yumeno-robot/ROCKET-Spica/ロケットの写真/48187062-D314-499D-9990-CD5C8455F660-6103-0000018686FA2A86.jpg

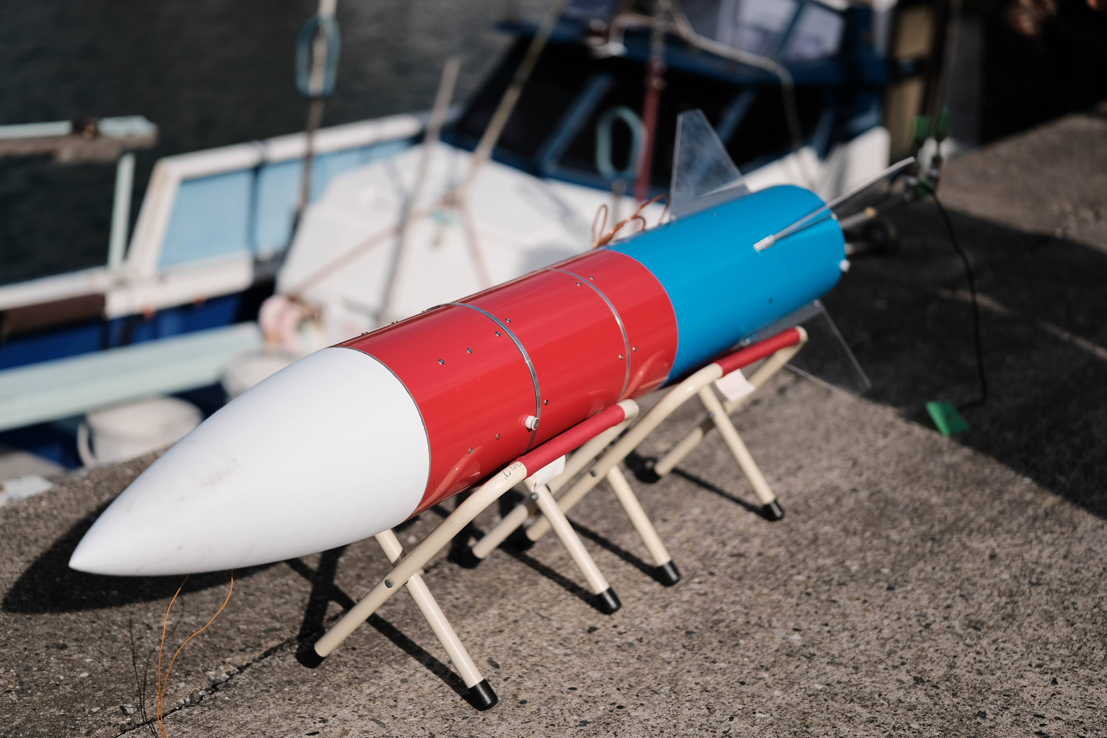
ロケットの写真/48187062-D314-499D-9990-CD5C8455F660-6103-0000018686FA2A86.jpg
