yumeno-robot/ROCKET-Spica/ロケットの写真/IMG_5005.jpg

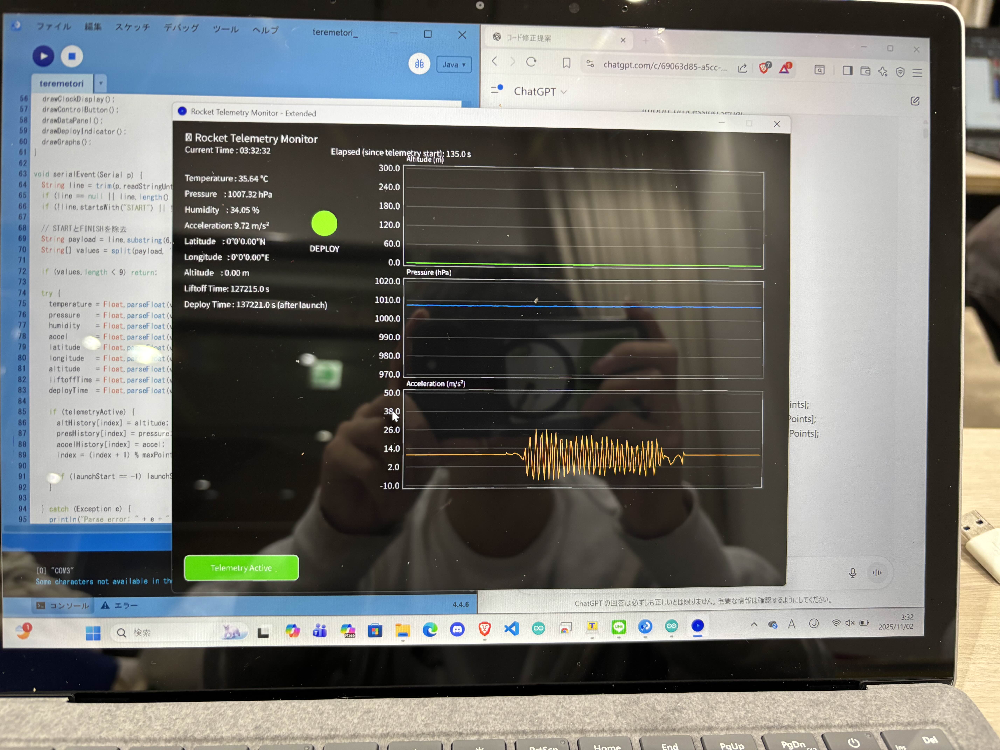
ロケットの写真/IMG_5005.jpg
