yumeno-robot/ROCKET-Spica/README.md

# 2025 年　ロケットガールズボーイ育成講座

2025 年　高校２年の時とある大学でロケット作ったのでそれのデータをまとめておきます。

★ 思い出残しのため ☆

写真データの中には私が撮ったものではないものが含まれます。
引用しないでください。
