yumeno-robot/ROCKET-Spica/A班 ロケット 使用手順書  .pdf

A 班 ロケット 使用手順書 | 第７回 御宿洋上発射実験

## 【全体像】

## ・右の写真が全体像です。

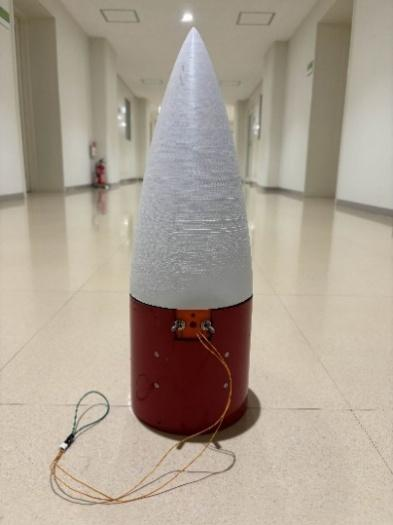
[picture p3: figure]

図１ 全体像
【部品】

### ・解放装置は主に右の写真の２

### つの部品によって構成されてい

ます。

## 左側：ノーズコーン

## 右側：機体チューブ

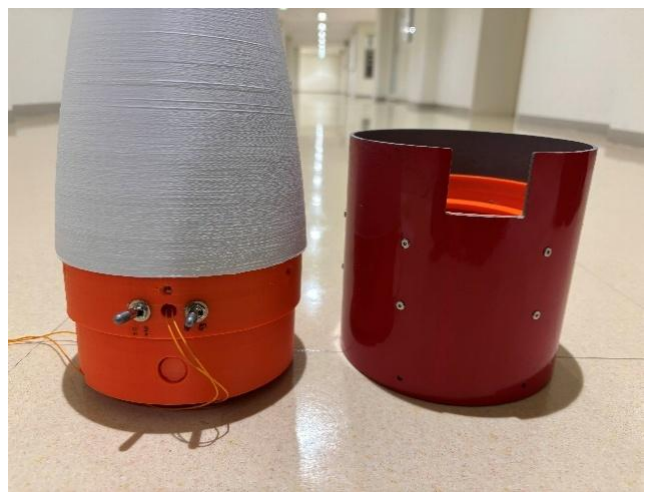
[picture p4: figure]

図２ 部品

## 【接続場所】

### ・スイッチが搭載されている部分と、

### くぼみのある機体チューブ部分を右の

### 写真のようになるように重ねてください。

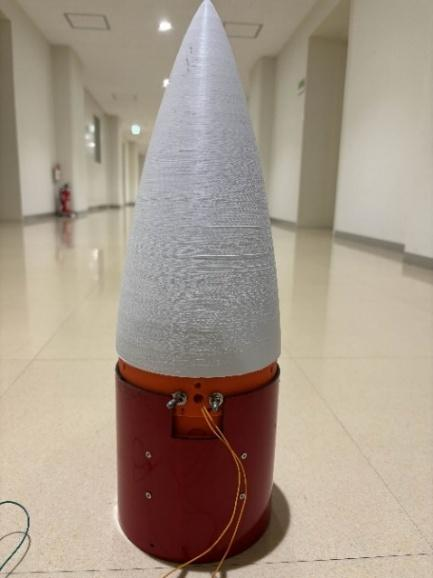
[picture p5: figure]

図３ 接続場所

## 【フライトピンの設置方法】

・２つのスイッチの間にある配線（オレンジ色の配線）の先端にジャンパーピンを取

り付け、ランチラグを囲むように接続してください。下画像の緑の配線の輪の中に、 ランチャーレールに引っかけるイメージです。

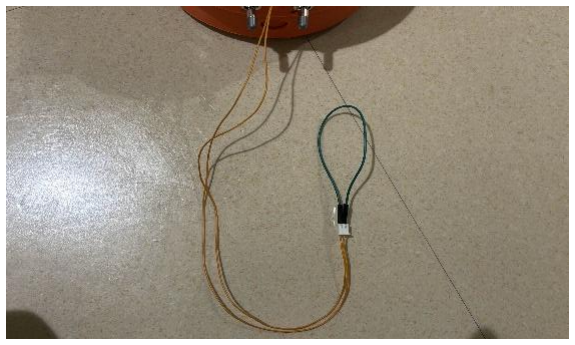
[picture p6: figure]

図４ フライトピン接続

## 【スイッチの操作方法】

・下の画像の青で囲った左側にあるスイッチは主電源スイッチです。 スイッチ左側が「ON」、
スイッチ右側が「OFF」です。
・下の画像の緑で囲った右側にあるスイッチは解放スイッチです。 スイッチ左側が「開ける」、
スイッチ右側が「閉める」です。

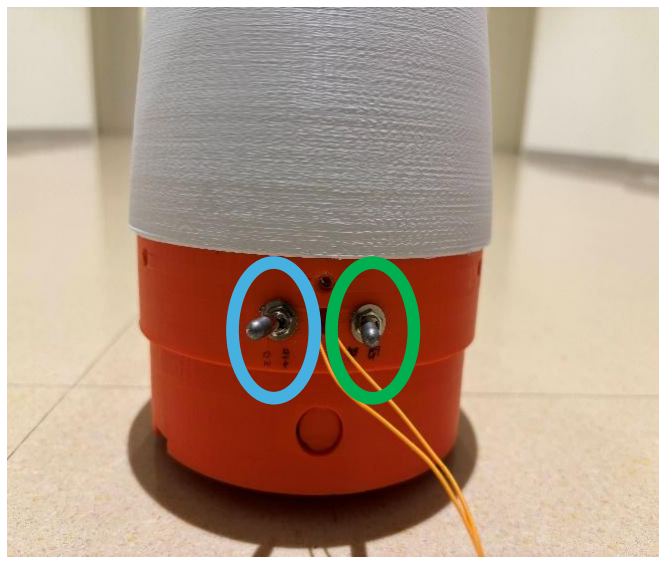
[picture p7: figure]

図５ 操作スイッチ

## 【通常手順】

① ロケットを発射台に設置してください。
② 「フライトピンの設置方法(図 4)」を参考にしてフライトピンをランチャーレール に設置してください。
③ 右側のスイッチが右側に傾いていることを確認してください。 （左側に傾いている場合、以下に示す「誤解放時」を行ってください。） ④ 左側のスイッチを操作し、電源を ON してくだい。
⑤ 電源をＯＮした後、２分ほどそのままにしてください。 （ＧＰＳが衛星と通信するまで時間をおいています。）
⑥ 以上です。

## 【誤開放時】

① 「接続場所(図３)」で示した接続場所にノーズコーンを置いてください。
② 「フライトピンの設置方法(図４)」で示したようにフライトピンを設置してくださ い。
③ 上の２つが完了したら左側のスイッチを操作し、電源を ON にしてくだい。 ④ 約５秒以上後、右側のスイッチを操作し、ピンを開けてください。
⑤ ノーズコーンを上から下に押してください。
⑥ ⑤を維持した状態で右側のスイッチを操作し、ピンを閉じてください。 ⑦ 左側のスイッチを操作し、電源を OFF にしてくだい。
⑧ 以上です。ここから通常動作を行ってください

【注意】

・「フライトピンの設置方法(図４)」で示したフライトピンの設置は電源 OFF の状態 で行ってください。電源 ON の状態でフライトピンを接続した場合、一度電源を OFF にしてからフライトピンをつなげてください。

・電源 ON 後、ロケット発射時以外にピンが抜けた場合、「通常手順」を再度行って ください。

・状態によっては右側のスイッチが右側に倒れている状態で解放機構が開いている場 合があります。その場合、前述した「誤開放時」を行ってください。
