yumeno-robot/ROCKET-Spica/ロケットの写真/0FC90A57-BD46-4F86-B61C-3EA1CAC522D2-6103-000001853AC63B2C.jpg

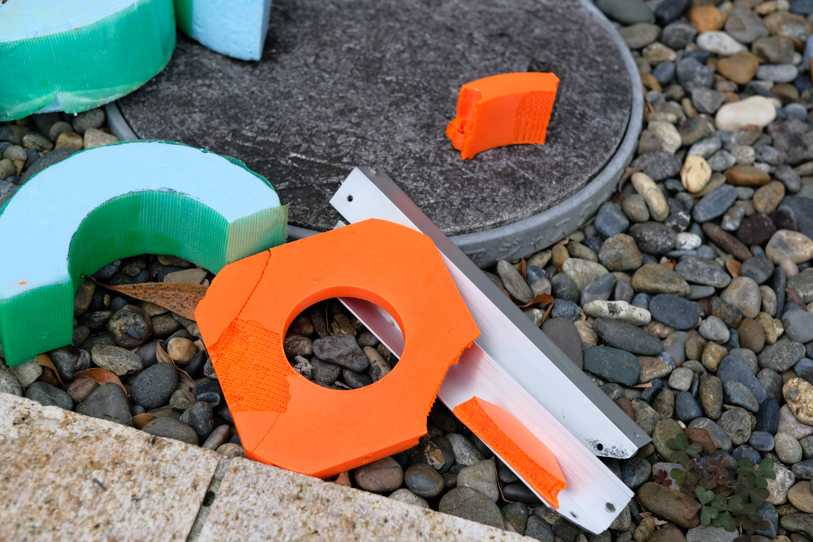
ロケットの写真/0FC90A57-BD46-4F86-B61C-3EA1CAC522D2-6103-000001853AC63B2C.jpg
