yumeno-robot/ROCKET-Spica/ロケットの写真/1CD4CB5B-3B7A-4239-A2F9-115B0FA8B15C-6103-000001851CA60BF3.jpg

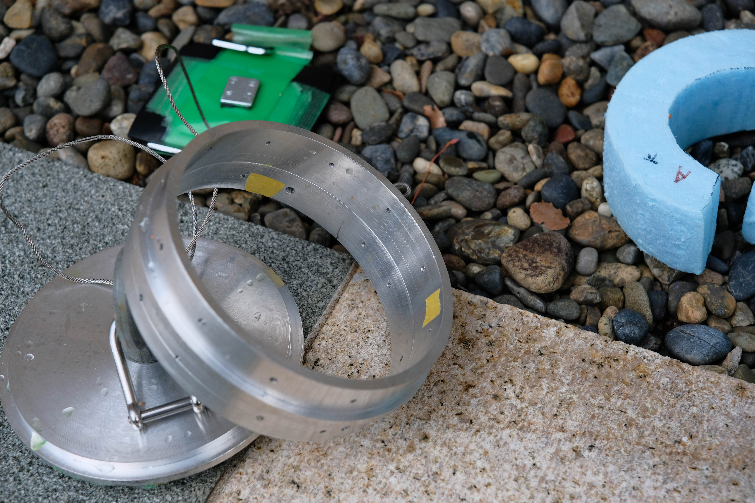
ロケットの写真/1CD4CB5B-3B7A-4239-A2F9-115B0FA8B15C-6103-000001851CA60BF3.jpg
