yumeno-robot/ROCKET-Spica/ロケットの写真/2F6D10CE-1B9F-4C32-9F9A-94F8F6FA369D-6103-00000184AF13A0E2.jpg

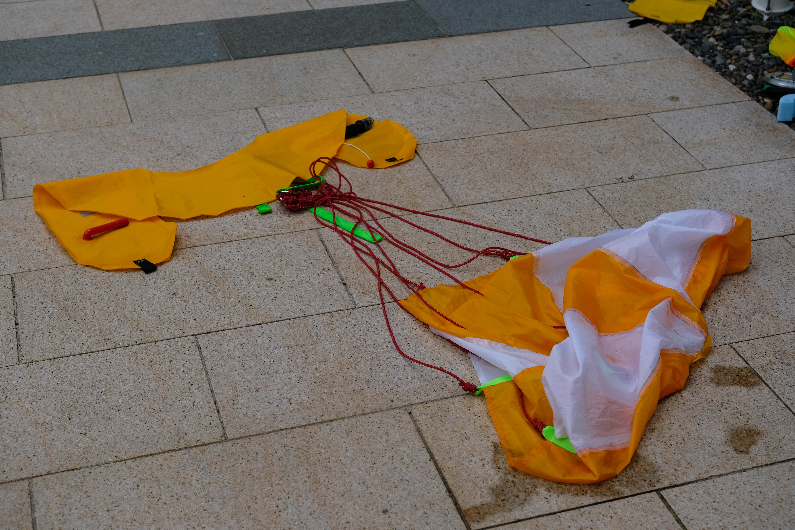
ロケットの写真/2F6D10CE-1B9F-4C32-9F9A-94F8F6FA369D-6103-00000184AF13A0E2.jpg
