yumeno-robot/ROCKET-Spica/ロケットの写真/4D69F9DE-7FC8-487E-84F1-985EA8C4742D-4056-0000011EC3DCB441.jpg

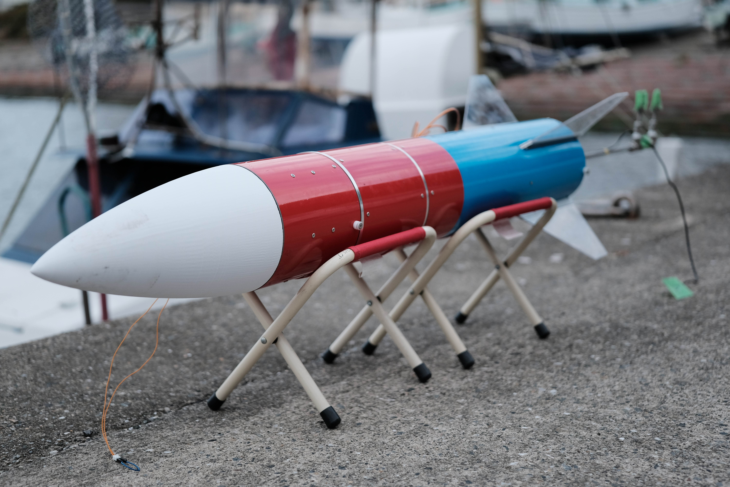
ロケットの写真/4D69F9DE-7FC8-487E-84F1-985EA8C4742D-4056-0000011EC3DCB441.jpg
