yumeno-robot/ROCKET-Spica/ロケットの写真/8B6EB3DB-4AFF-46E7-9A49-E1A825BA8A68-6103-000001863AD62E09.jpg

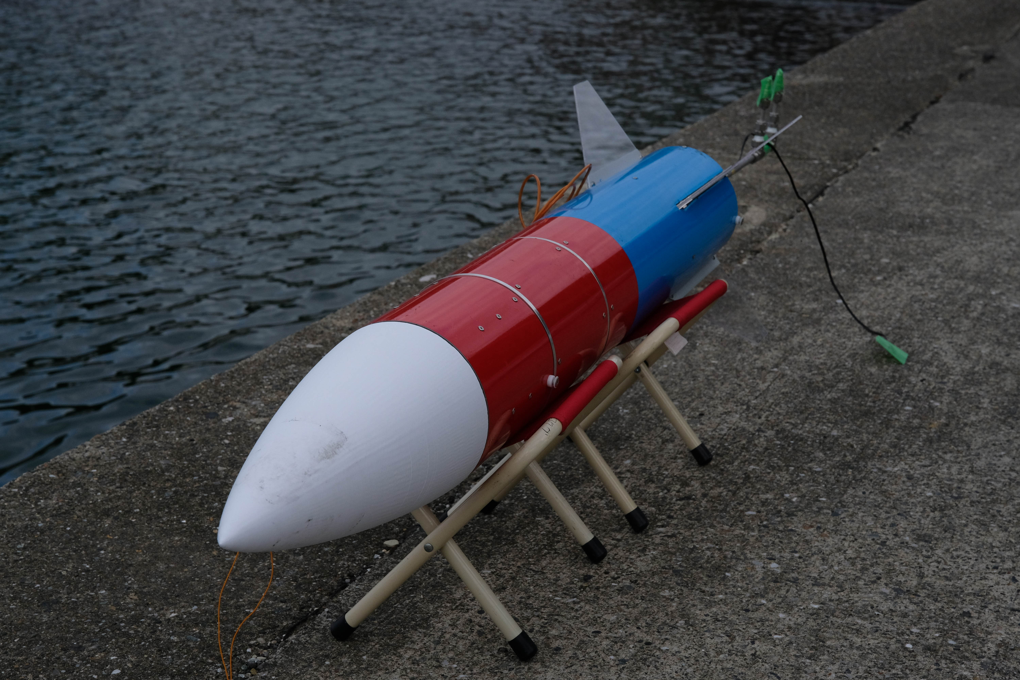
ロケットの写真/8B6EB3DB-4AFF-46E7-9A49-E1A825BA8A68-6103-000001863AD62E09.jpg
