yumeno-robot/ROCKET-Spica/ロケットの写真/675B1E63-8A9D-4DF6-90D7-148300A42DEA-44823-0000099A16C7EF28.jpg

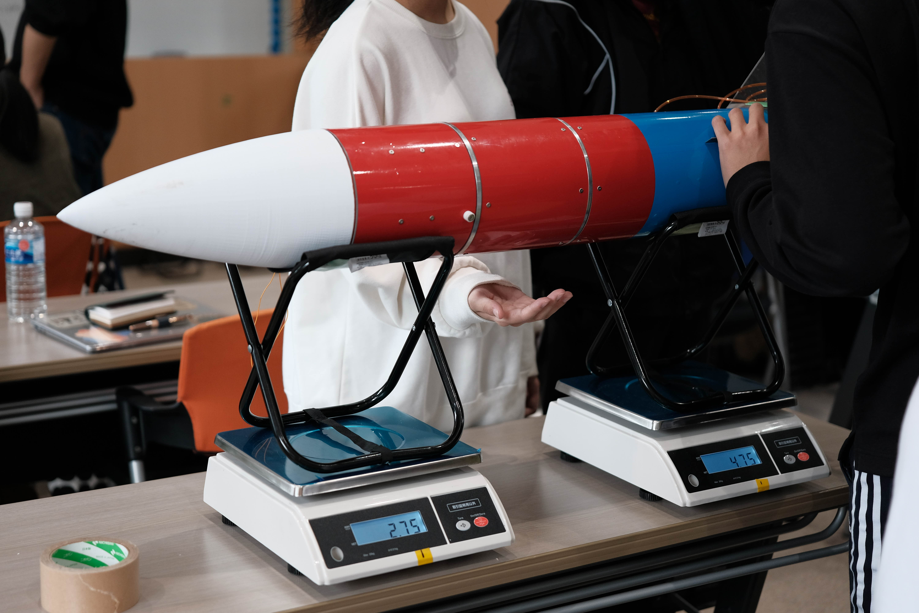
ロケットの写真/675B1E63-8A9D-4DF6-90D7-148300A42DEA-44823-0000099A16C7EF28.jpg
