yumeno-robot/ROCKET-Spica/ロケットの写真/894C506B-190F-47E7-8913-344BC54AA54C-6103-000001850DC50F10.jpg

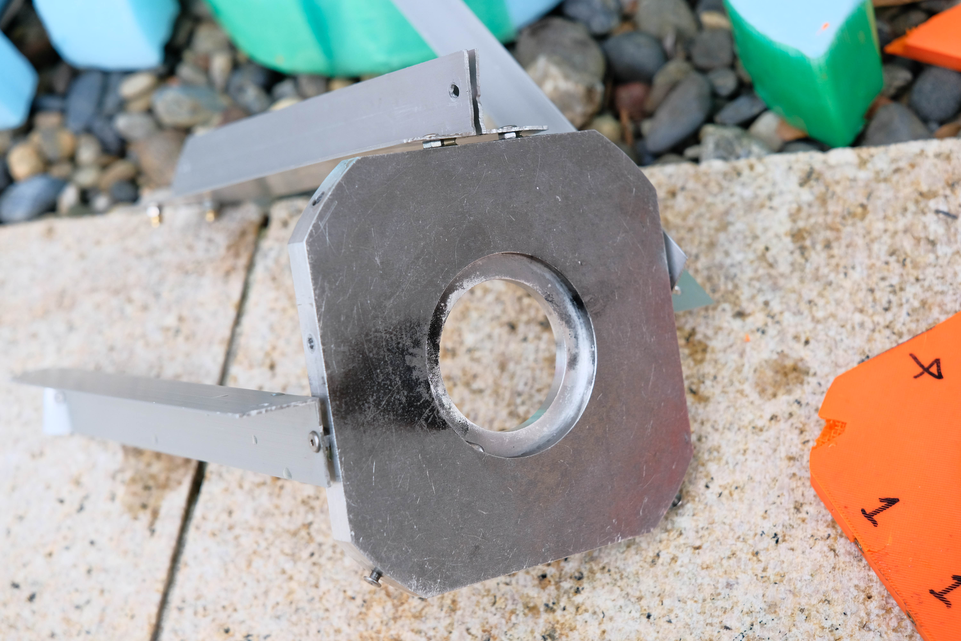
ロケットの写真/894C506B-190F-47E7-8913-344BC54AA54C-6103-000001850DC50F10.jpg
