yumeno-robot/ROCKET-Spica/ロケットの写真/4950B2CF-F425-4C80-BBA5-A1028AC1AF88-6103-00000184D413493E.jpg

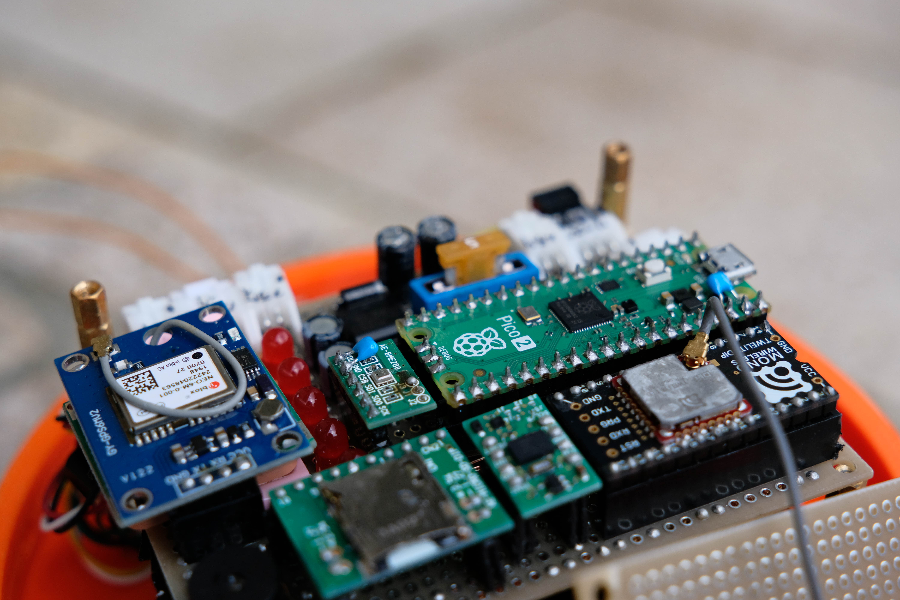
ロケットの写真/4950B2CF-F425-4C80-BBA5-A1028AC1AF88-6103-00000184D413493E.jpg
