yumeno-robot/ROCKET-Spica/ロケットの写真/210455AF-9EFC-4293-8BE5-35B574340314-6103-000001852D3EDECA.jpg

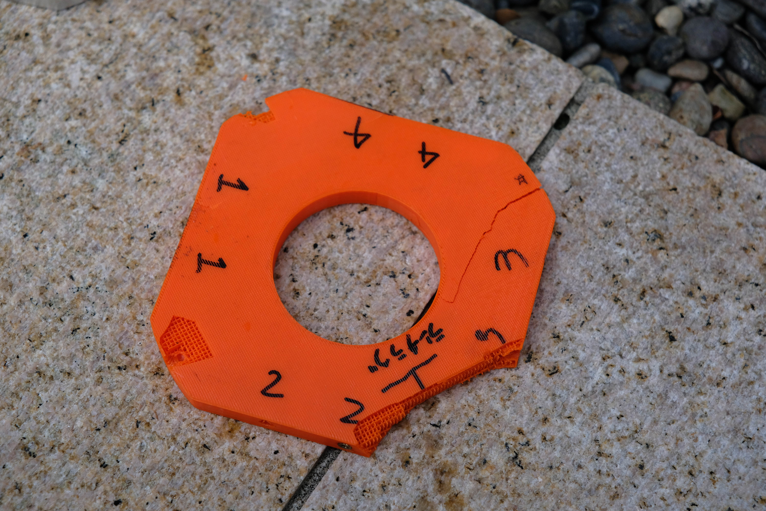
ロケットの写真/210455AF-9EFC-4293-8BE5-35B574340314-6103-000001852D3EDECA.jpg
