yumeno-robot/ROCKET-Spica/ロケットの写真/877230B7-5BA3-433E-8952-C34C328BABE0-44823-00000999D73E7EAC.jpg

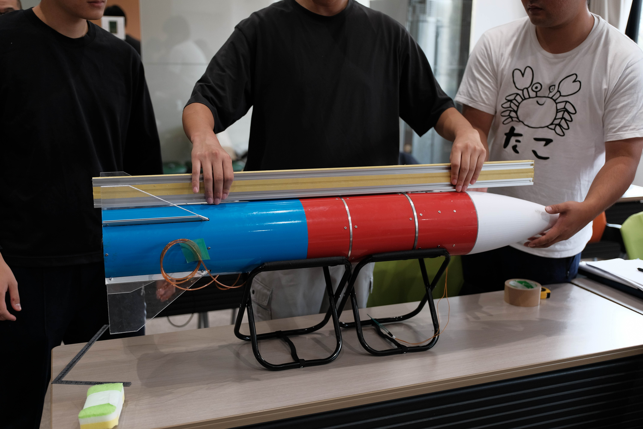
ロケットの写真/877230B7-5BA3-433E-8952-C34C328BABE0-44823-00000999D73E7EAC.jpg
