yumeno-robot/ROCKET-Spica/ロケットの写真/928958B4-A0EA-4850-AB8D-C0FD10C378C6-44823-000009990B5FE514.jpg

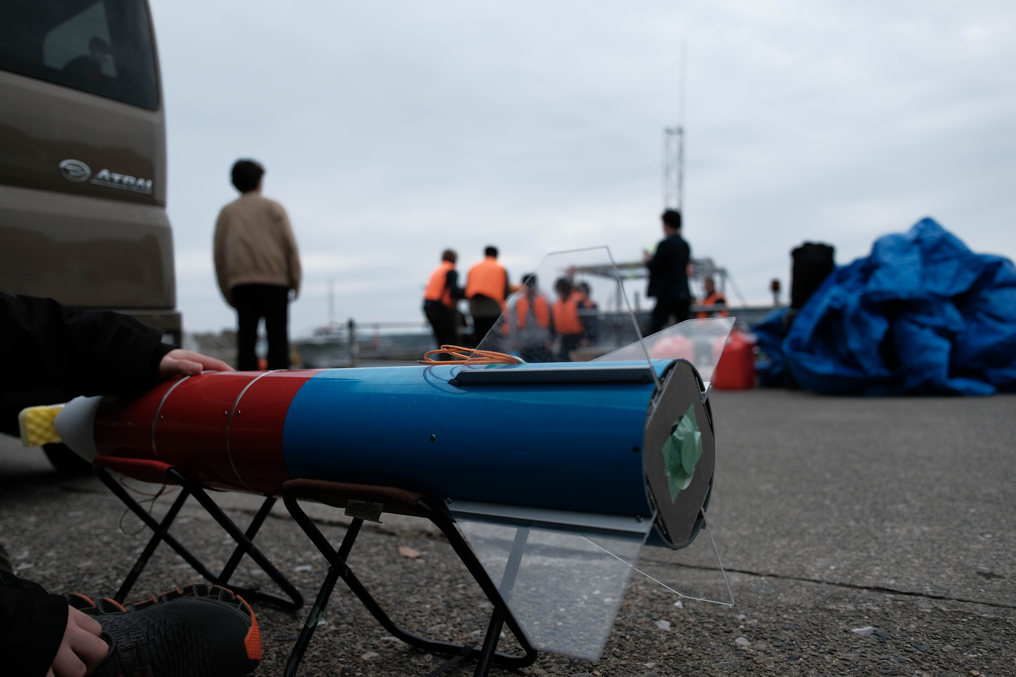
ロケットの写真/928958B4-A0EA-4850-AB8D-C0FD10C378C6-44823-000009990B5FE514.jpg
