yumeno-robot/ROCKET-Spica/ロケットの写真/A9FA2B79-7A4F-4A39-996E-ED2CC38B4577-6103-00000186A8F1BF98.jpg

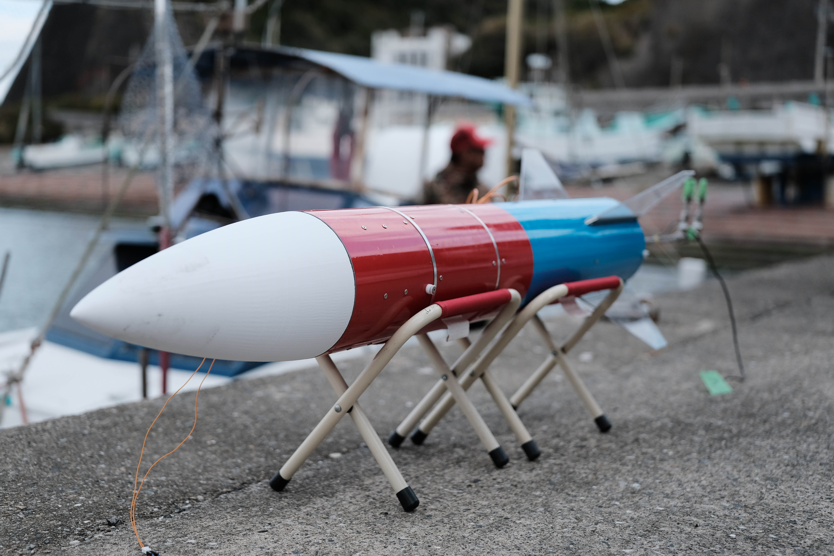
ロケットの写真/A9FA2B79-7A4F-4A39-996E-ED2CC38B4577-6103-00000186A8F1BF98.jpg
