yumeno-robot/ROCKET-Spica/ロケットの写真/A365B580-1068-411D-A24B-DBDF7330468E-6103-00000184F07EAC1B.jpg

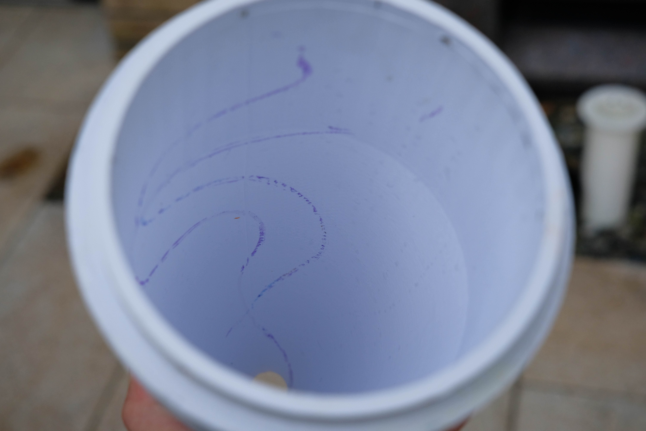
ロケットの写真/A365B580-1068-411D-A24B-DBDF7330468E-6103-00000184F07EAC1B.jpg
