yumeno-robot/ROCKET-Spica/ロケットの写真/BC89DCE3-93C0-48F0-8FF4-2F83AFA3876C-6103-00000184E5706E08.jpg

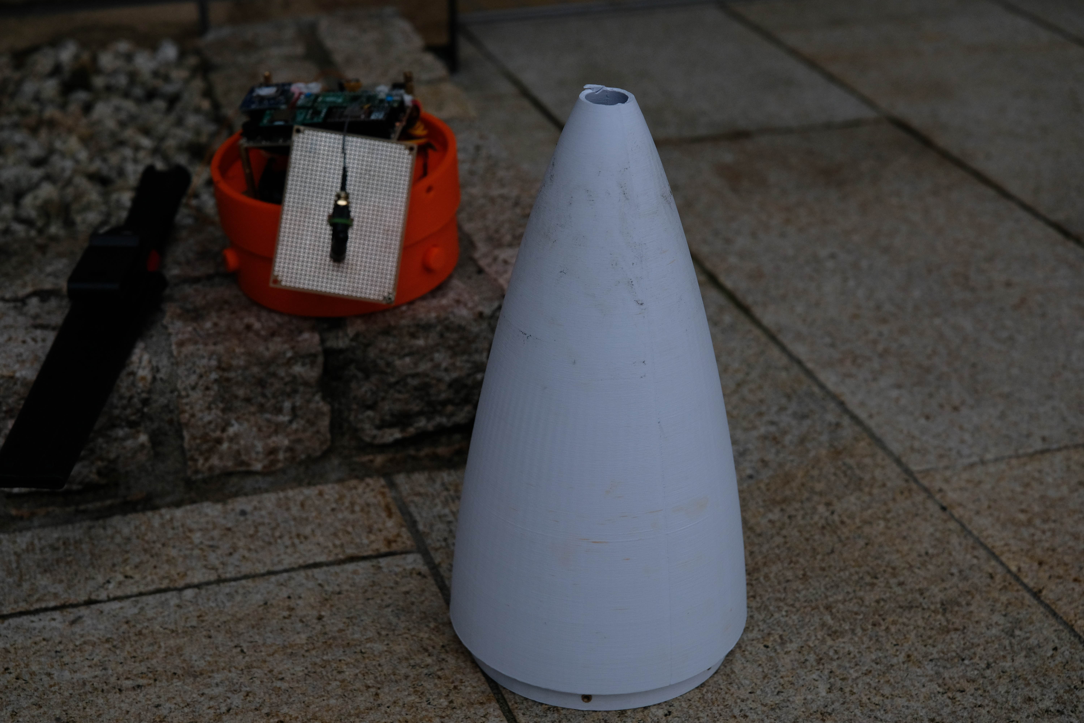
ロケットの写真/BC89DCE3-93C0-48F0-8FF4-2F83AFA3876C-6103-00000184E5706E08.jpg
