yumeno-robot/ROCKET-Spica/ロケットの写真/BD18CD77-5427-4790-9A3F-752F933EEAA5-4056-0000011ED44F400C.jpg

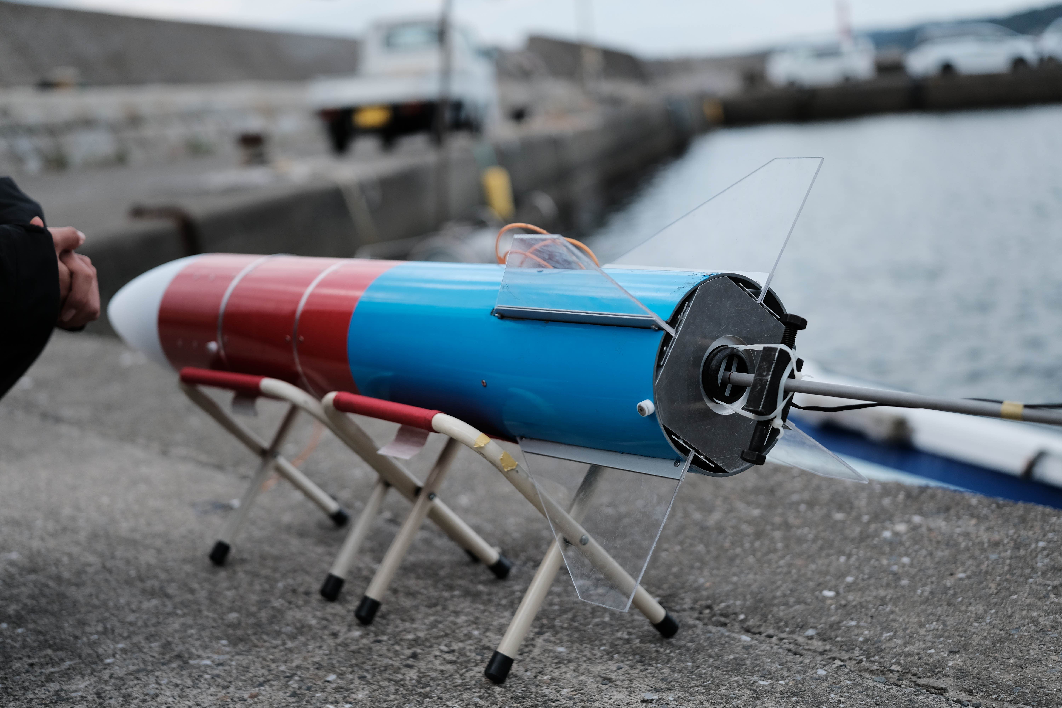
ロケットの写真/BD18CD77-5427-4790-9A3F-752F933EEAA5-4056-0000011ED44F400C.jpg
