yumeno-robot/ROCKET-Spica/ロケットの写真/C8CE9DC4-7D7F-4F7A-AB00-0D97CFE91414-6103-000001850279BE9D.jpg

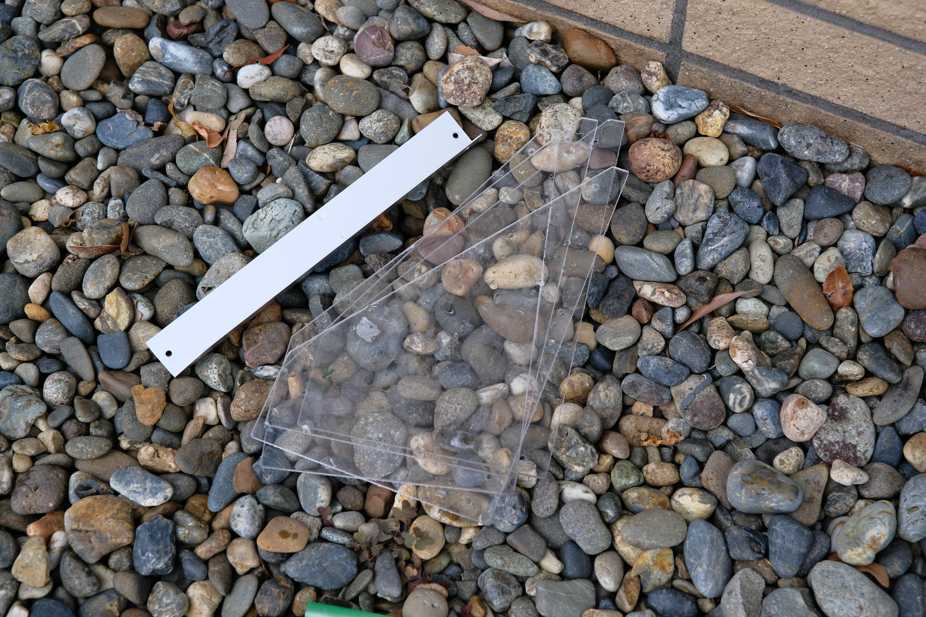
ロケットの写真/C8CE9DC4-7D7F-4F7A-AB00-0D97CFE91414-6103-000001850279BE9D.jpg
