yumeno-robot/ROCKET-Spica/ロケットの写真/CDED8A6D-13CD-4E98-A0E0-FBBDD8B04306-6103-0000018545E437C1.jpg

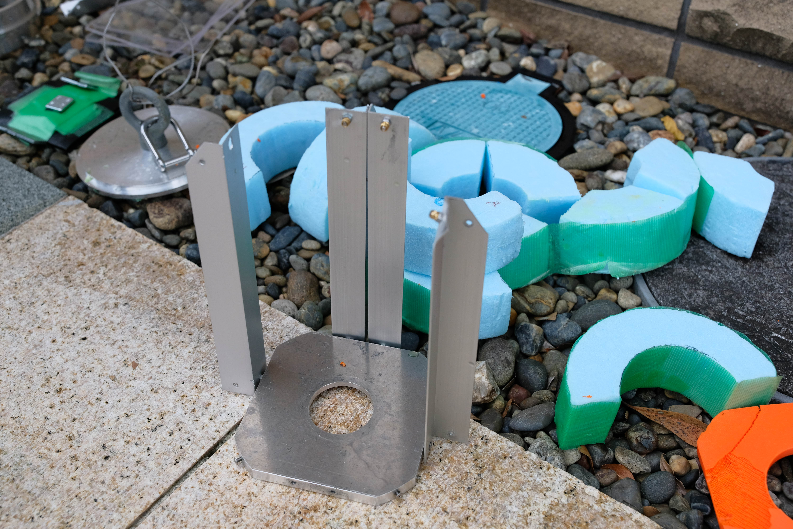
ロケットの写真/CDED8A6D-13CD-4E98-A0E0-FBBDD8B04306-6103-0000018545E437C1.jpg
