yumeno-robot/ROCKET-Spica/ロケットの写真/D8361926-20F7-44C3-A4CB-8BE9D1C3B104-6103-00000184C01F9074.jpg

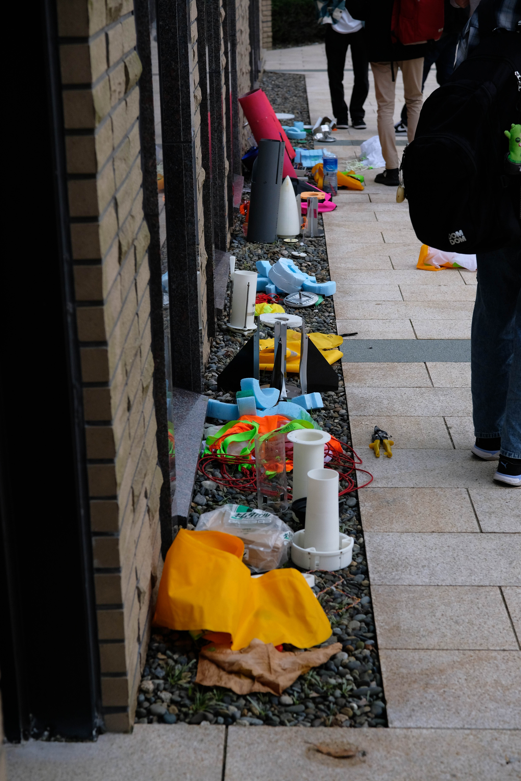
ロケットの写真/D8361926-20F7-44C3-A4CB-8BE9D1C3B104-6103-00000184C01F9074.jpg
