yumeno-robot/ROCKET-Spica/ロケットの写真/DSC1547_Original.jpg

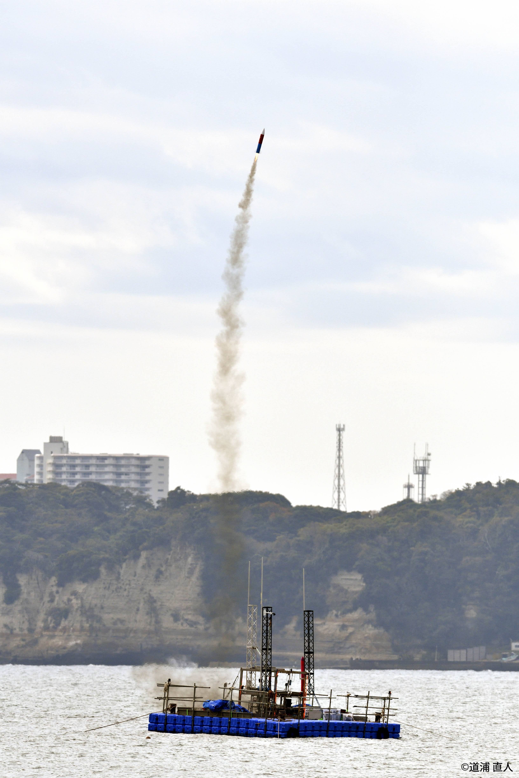
ロケットの写真/DSC1547_Original.jpg
