yumeno-robot/ROCKET-Spica/ロケットの写真/DSC2054_Original.jpg

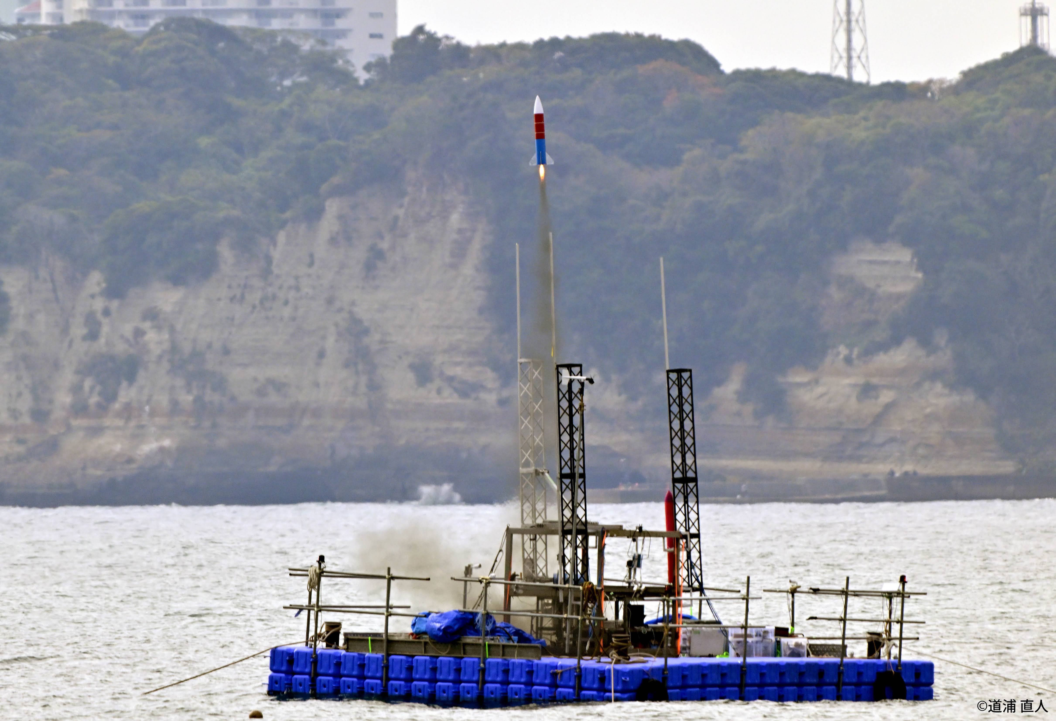
ロケットの写真/DSC2054_Original.jpg
