yumeno-robot/ROCKET-Spica/ロケットの写真/DSC2071_Original.jpg

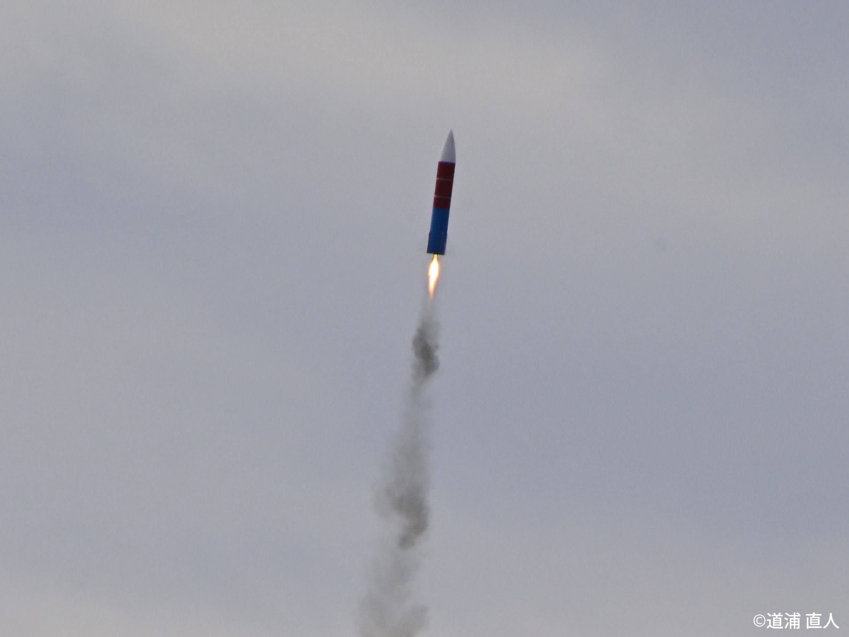
ロケットの写真/DSC2071_Original.jpg
