yumeno-robot/ROCKET-Spica/ロケットの写真/DSC2210_Original.jpg

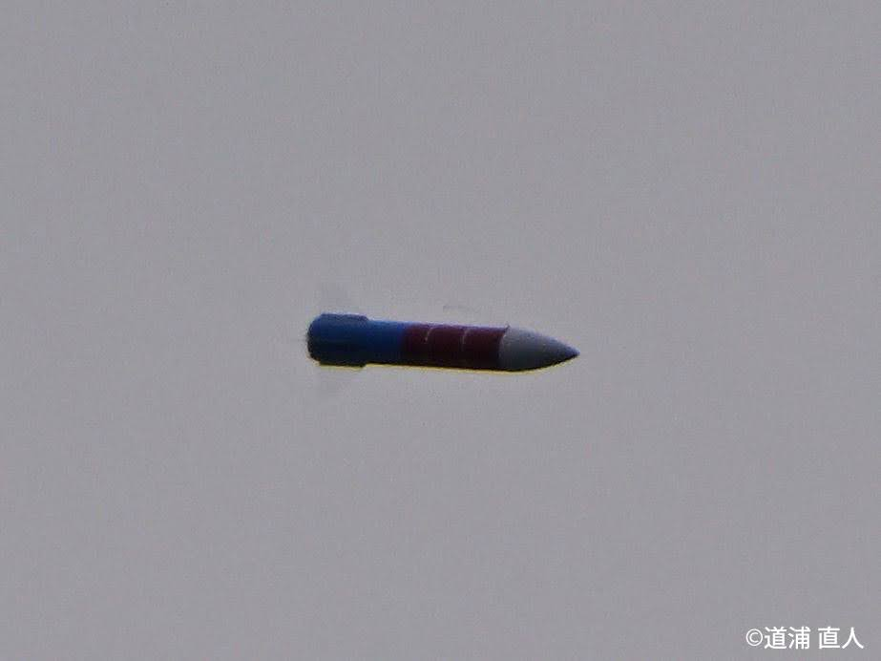
ロケットの写真/DSC2210_Original.jpg
