yumeno-robot/ROCKET-Spica/ロケットの写真/DSC2316_Original.jpg

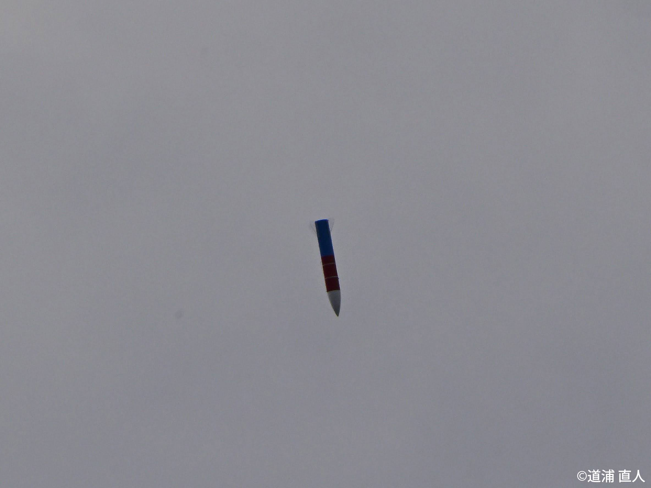
ロケットの写真/DSC2316_Original.jpg
