yumeno-robot/ROCKET-Spica/ロケットの写真/DSC2340_01_Original.jpg

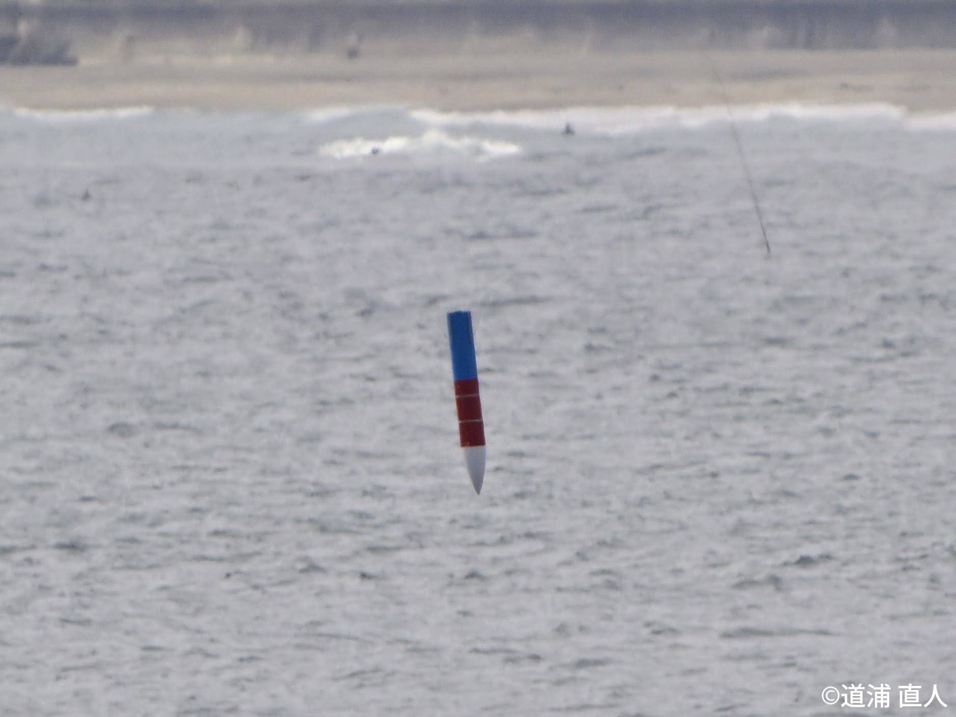
ロケットの写真/DSC2340_01_Original.jpg
