yumeno-robot/ROCKET-Spica/ロケットの写真/E9909897-1351-40BC-B9DE-F3F1F30117BF-6103-00000186566A3C08.jpg

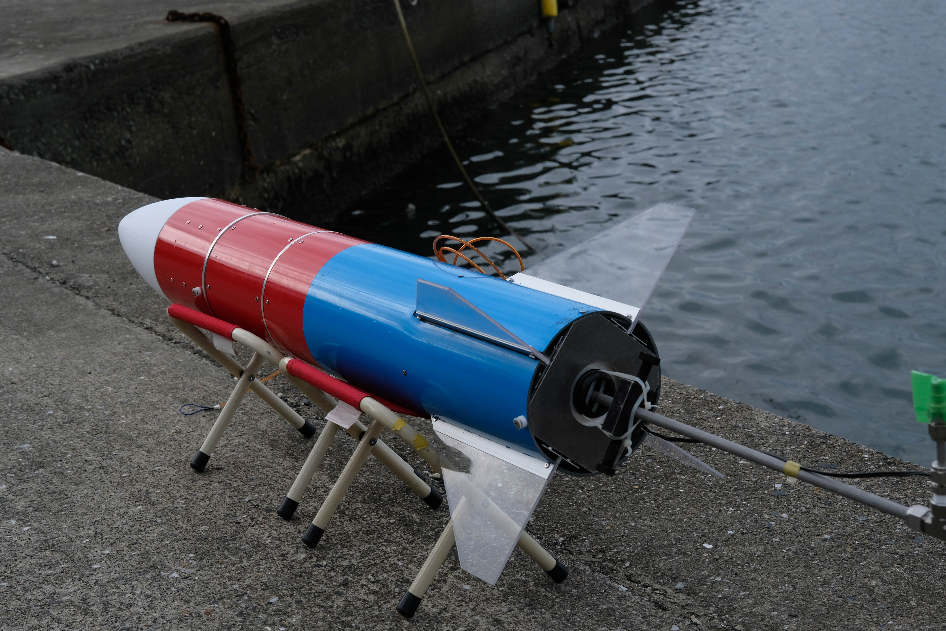
ロケットの写真/E9909897-1351-40BC-B9DE-F3F1F30117BF-6103-00000186566A3C08.jpg
