yumeno-robot/ROCKET-Spica/ロケットの写真/ED5EF804-89DA-4306-BC5D-3A83CC1A1FF2-6103-000001858AFEE430.jpg

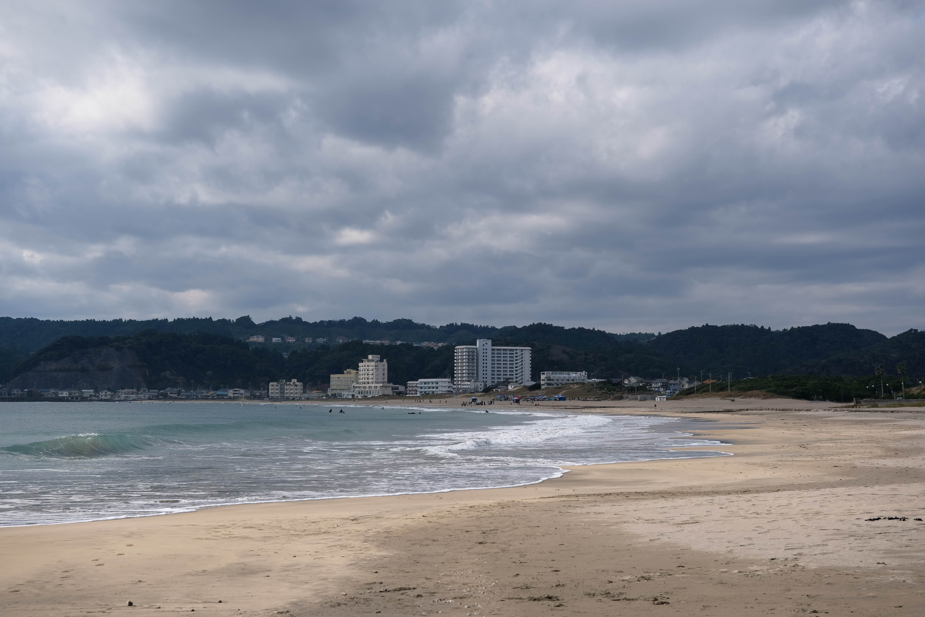
ロケットの写真/ED5EF804-89DA-4306-BC5D-3A83CC1A1FF2-6103-000001858AFEE430.jpg
