yumeno-robot/ROCKET-Spica/ロケットの写真/EEB0203D-555C-47D5-9C63-FC9DA25AA20E-6103-00000186E50B3417.jpg

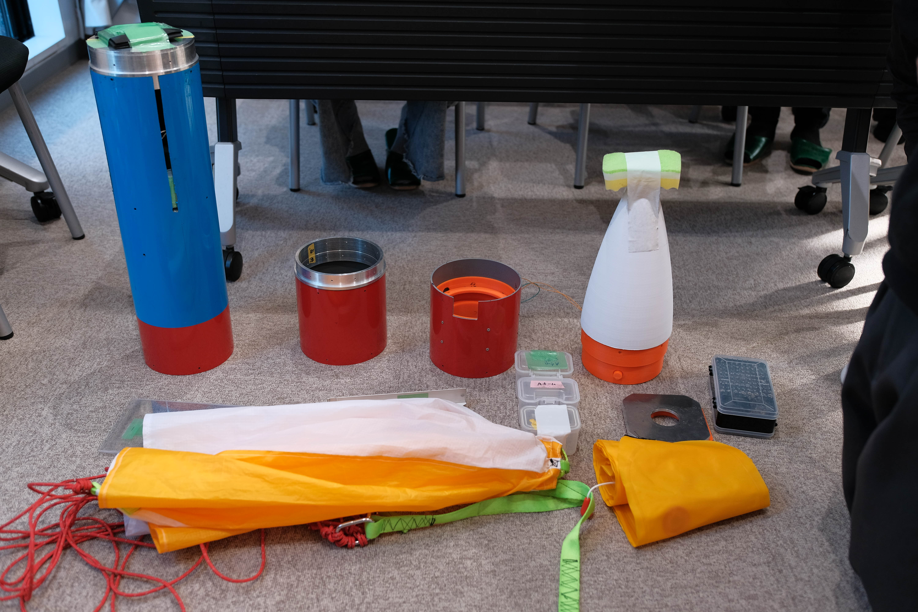
ロケットの写真/EEB0203D-555C-47D5-9C63-FC9DA25AA20E-6103-00000186E50B3417.jpg
