yumeno-robot/ROCKET-Spica/ロケットの写真/IMG_4200_Original.jpg

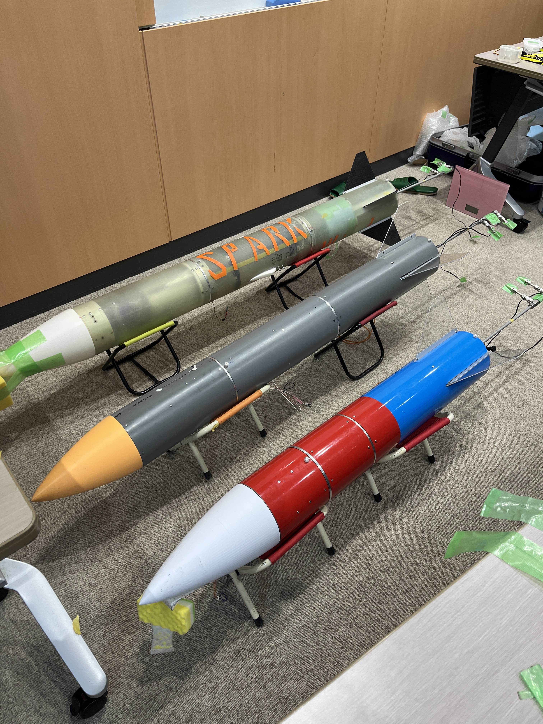
ロケットの写真/IMG_4200_Original.jpg
