yumeno-robot/ROCKET-Spica/ロケットの写真/IMG_4871.jpg

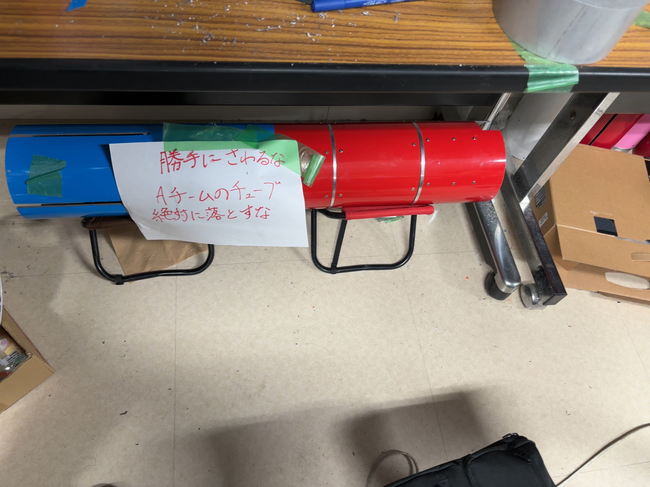
ロケットの写真/IMG_4871.jpg
