yumeno-robot/ROCKET-Spica/ロケットの写真/IMG_4982.jpg

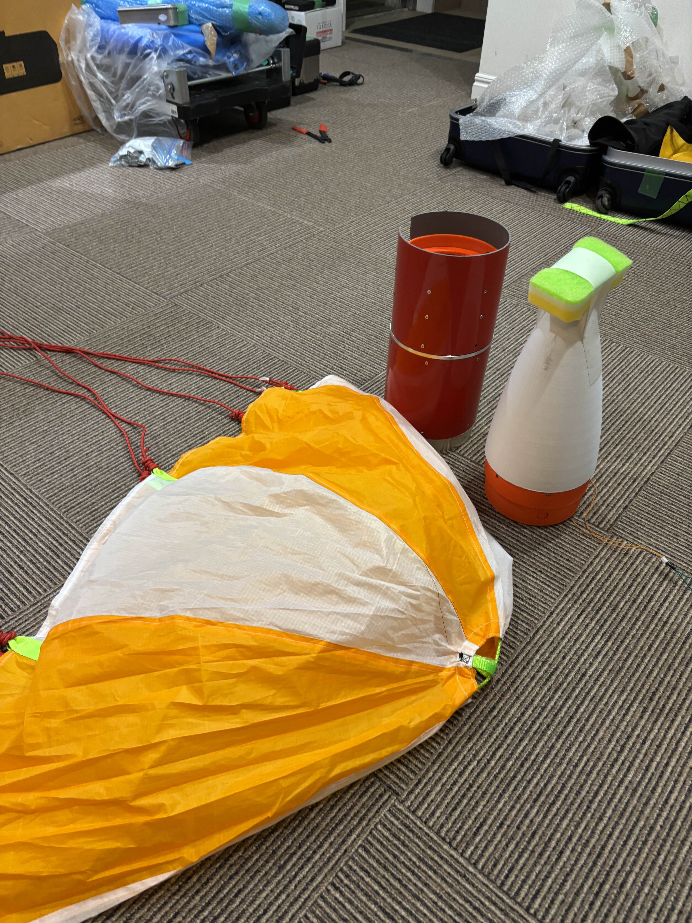
ロケットの写真/IMG_4982.jpg
