yumeno-robot/ROCKET-Spica/ロケットの写真/IMG_4983.jpg

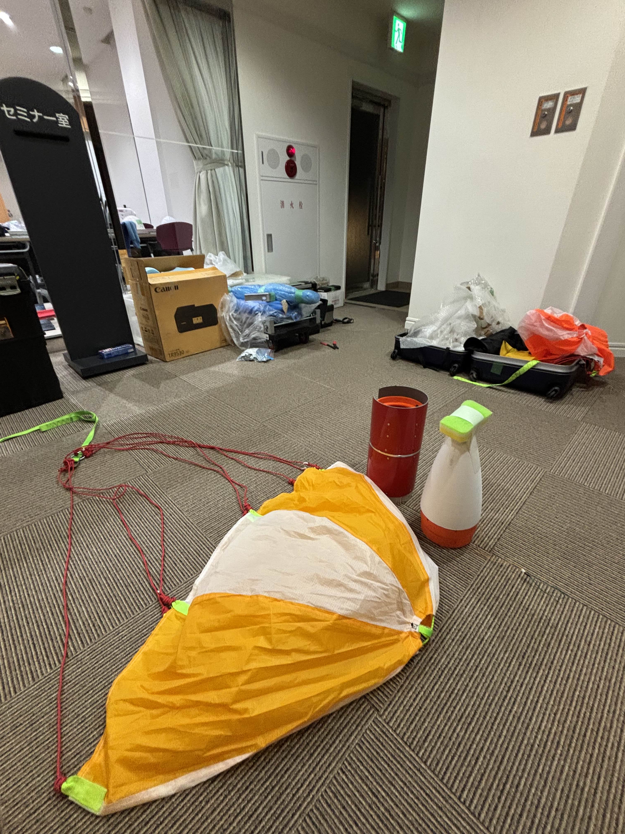
ロケットの写真/IMG_4983.jpg
