yumeno-robot/ROCKET-Spica/ロケットの写真/IMG_4984.jpg

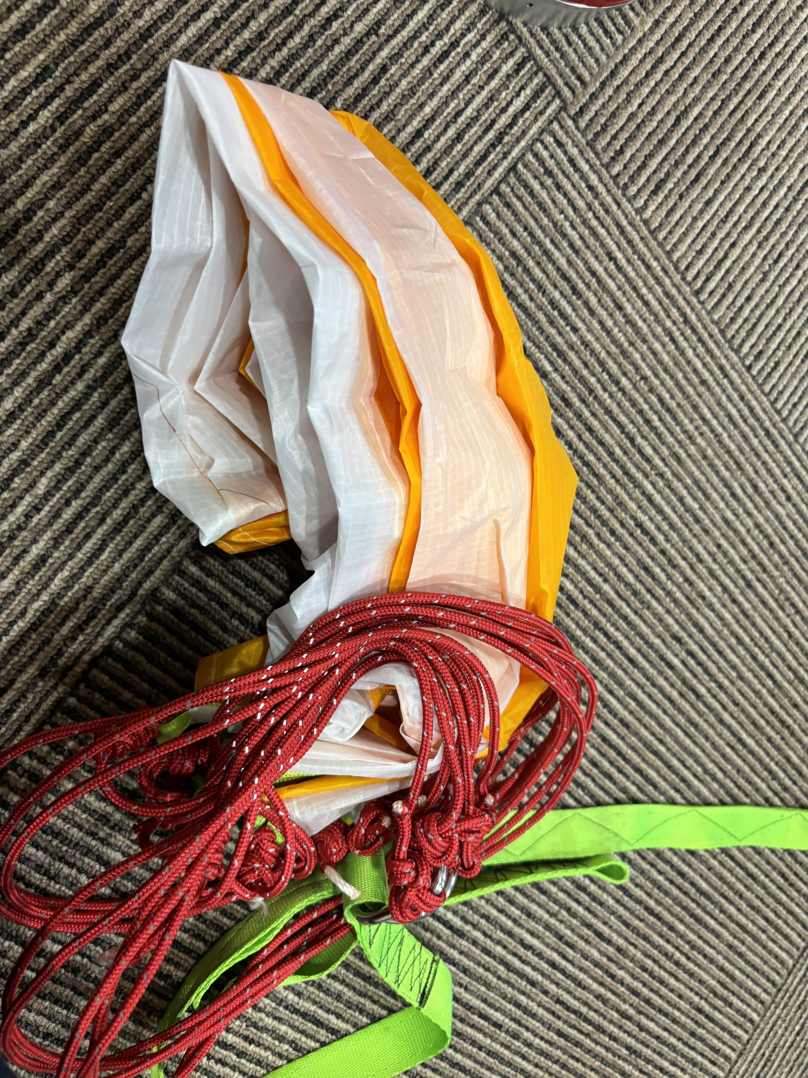
ロケットの写真/IMG_4984.jpg
