yumeno-robot/ROCKET-Spica/ロケットの写真/IMG_5441.jpg

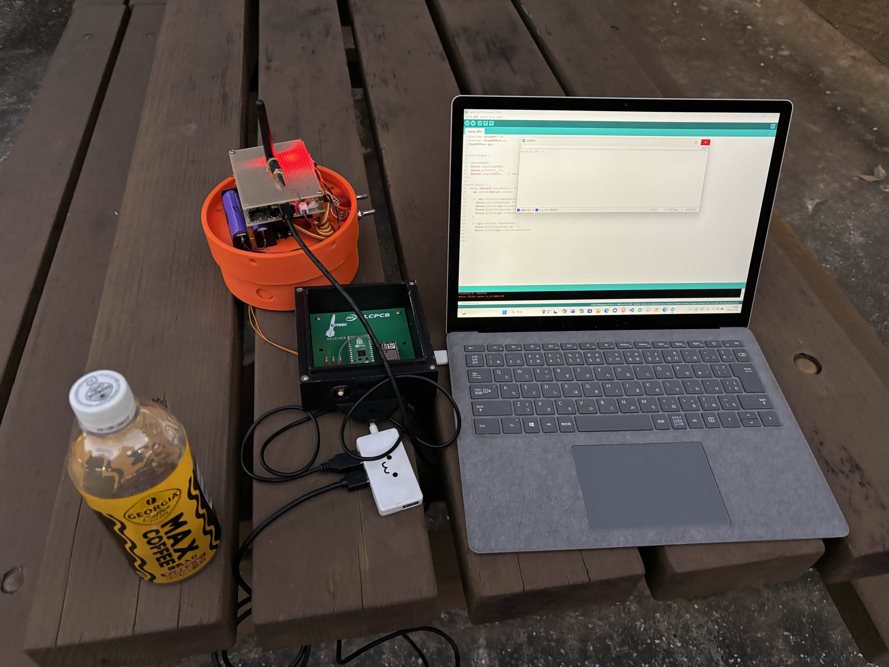
ロケットの写真/IMG_5441.jpg
