yumeno-robot/ROCKET-Spica/ロケットの写真/IMG_5715.jpg

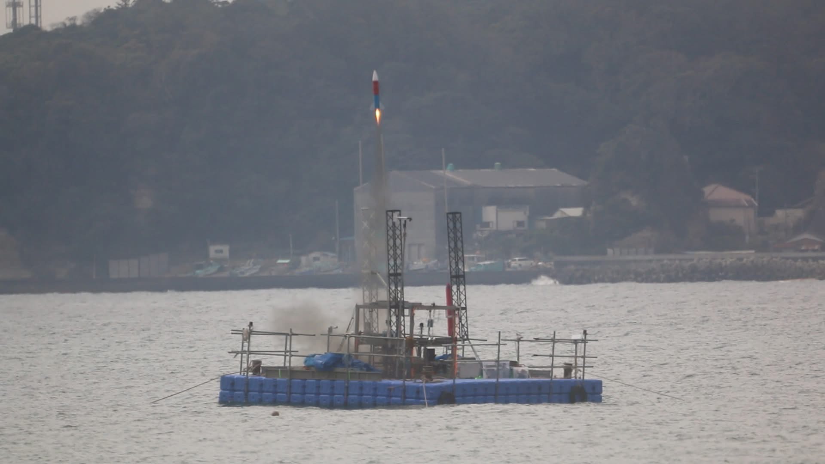
ロケットの写真/IMG_5715.jpg
