yumeno-robot/ROCKET-Spica/ロケットの写真/IMG_5728.jpg

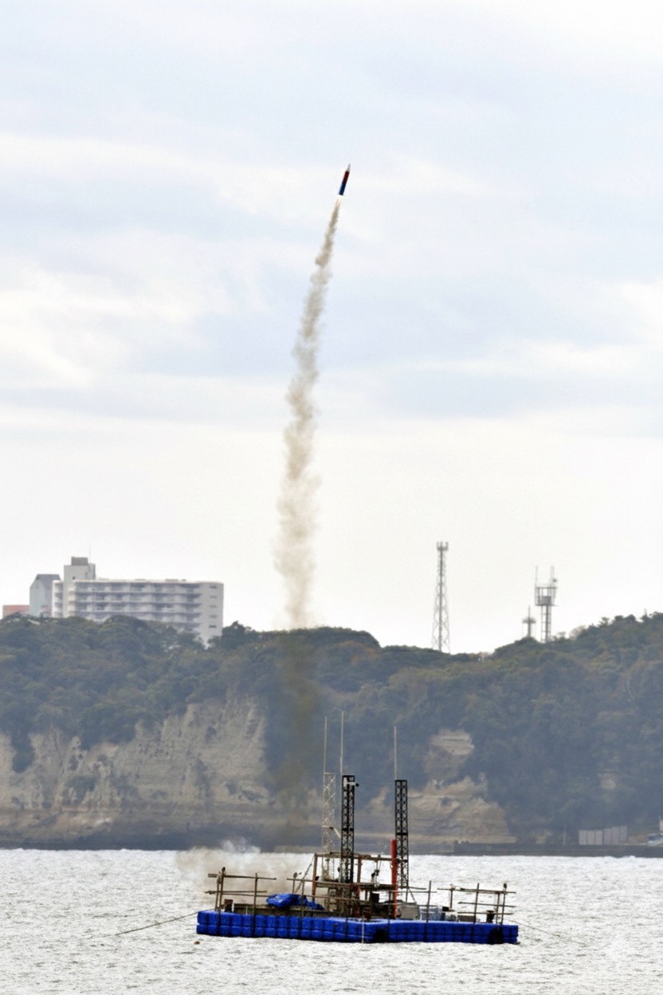
ロケットの写真/IMG_5728.jpg
