yumeno-robot/ROCKET-Spica/解析データ/GPSが動いてる証拠.png

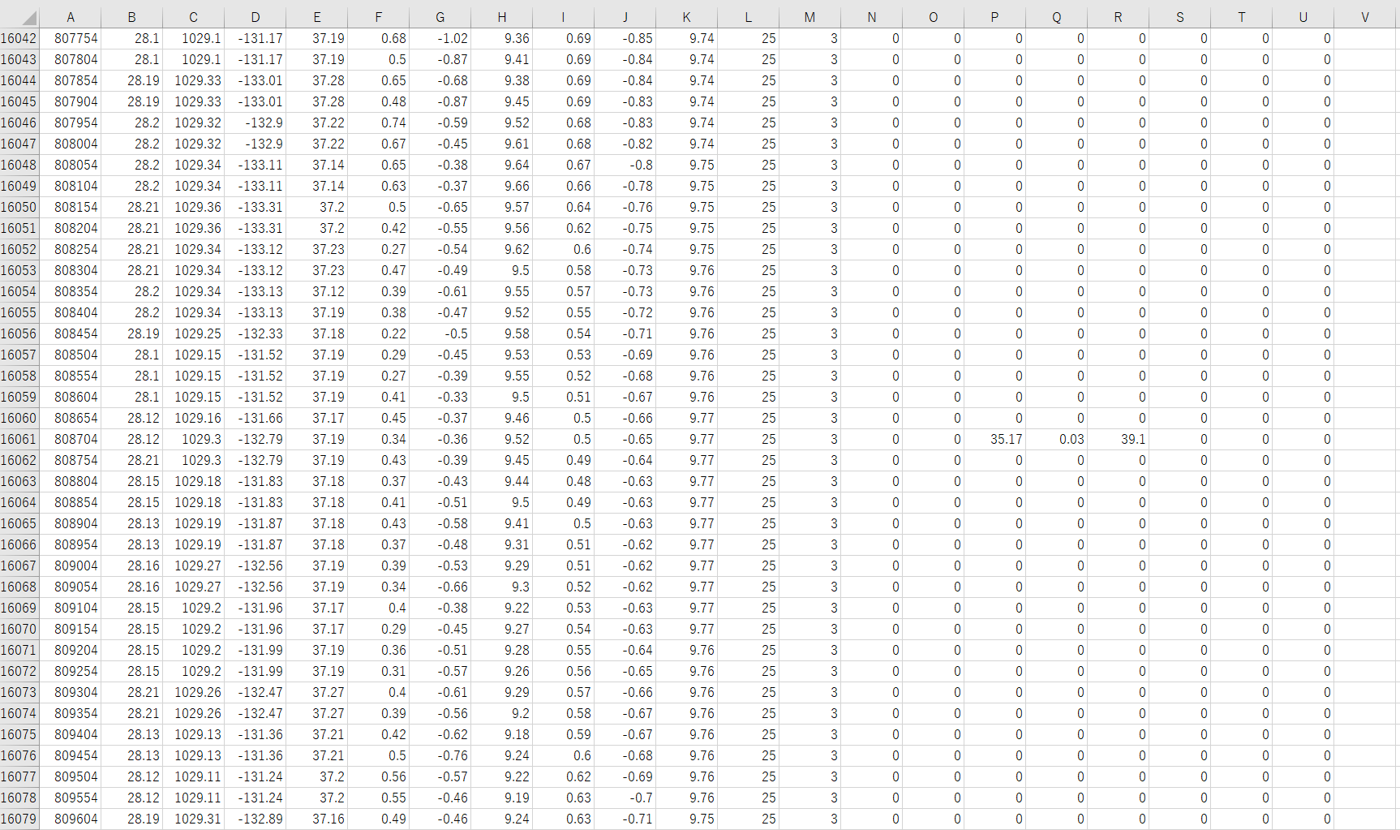
解析データ/GPSが動いてる証拠.png
