yumeno-robot/ROCKET-Spica/解析データ/SDカードに書きこんだデータ.png

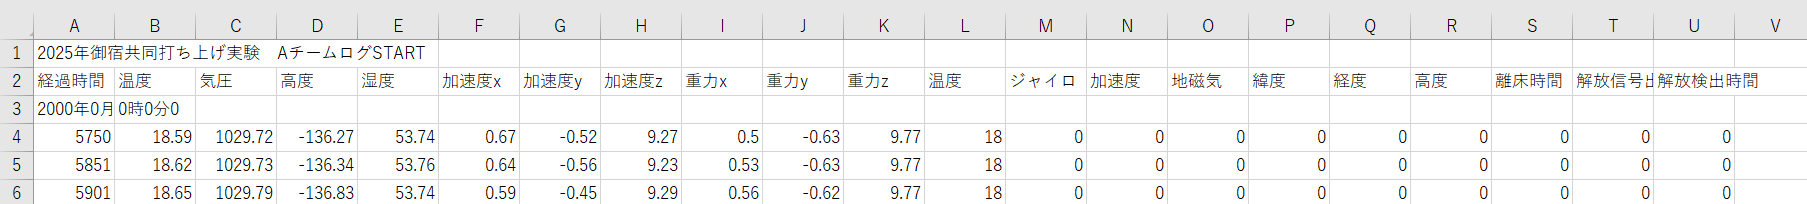
解析データ/SDカードに書きこんだデータ.png
