yumeno-robot/ROCKET-Spica/解析データ/テレメトリー画像.png

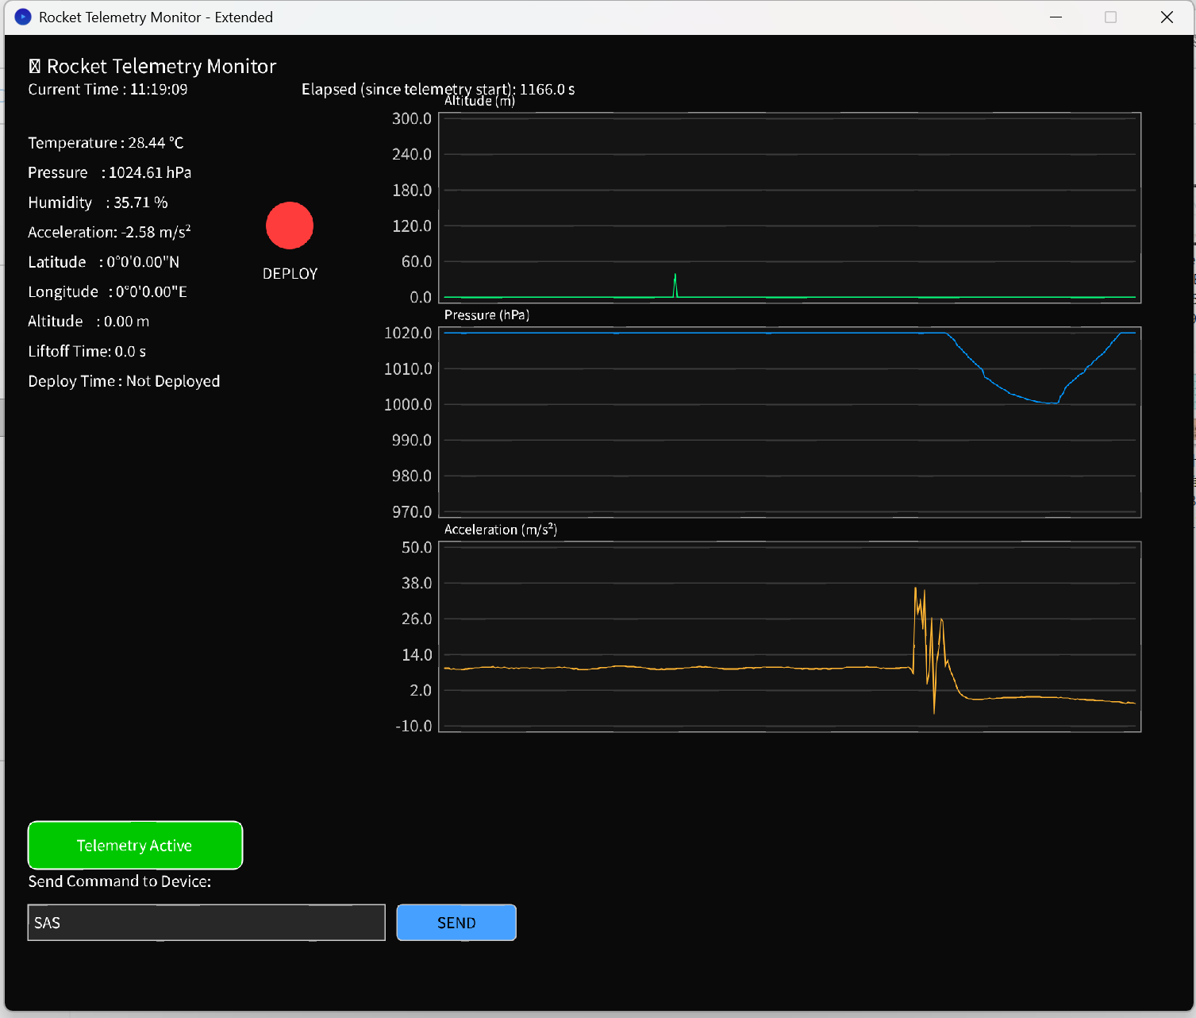
解析データ/テレメトリー画像.png
