yumeno-robot/ROCKET-Spica/解析データ/フライトピンの認識.png

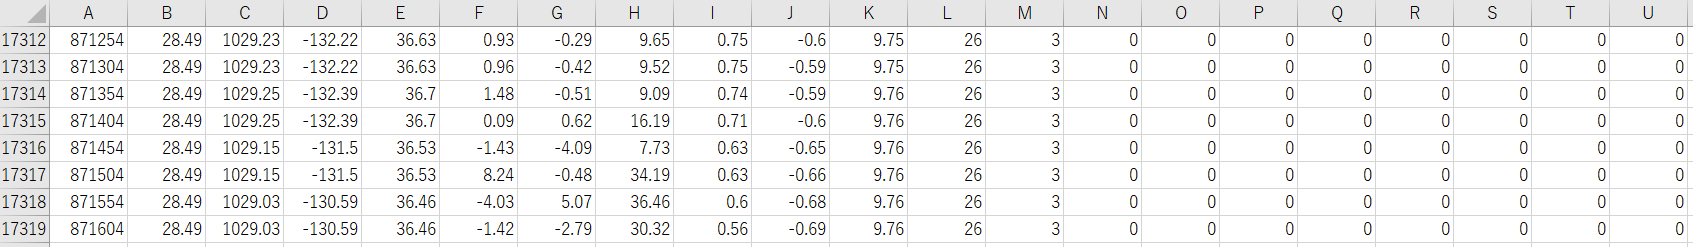
解析データ/フライトピンの認識.png
