yumeno-robot/ROCKET-Spica/解析データ/加速度.png

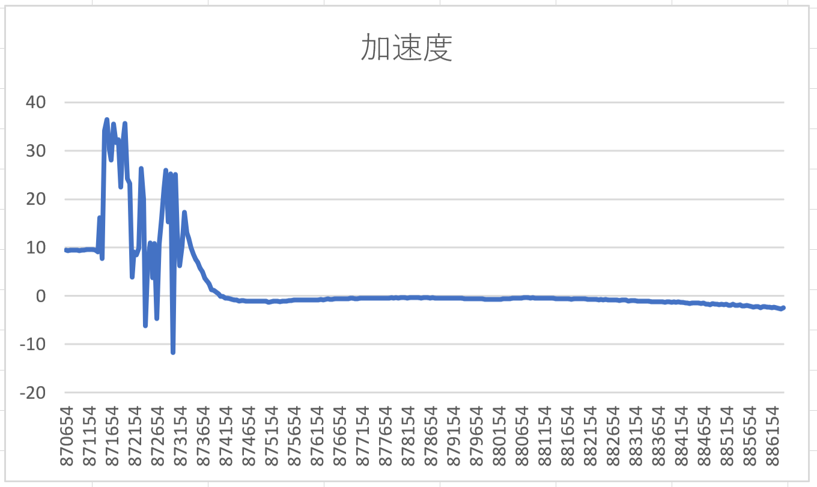
解析データ/加速度.png
