yumeno-robot/ROCKET-Spica/解析データ/気圧.png

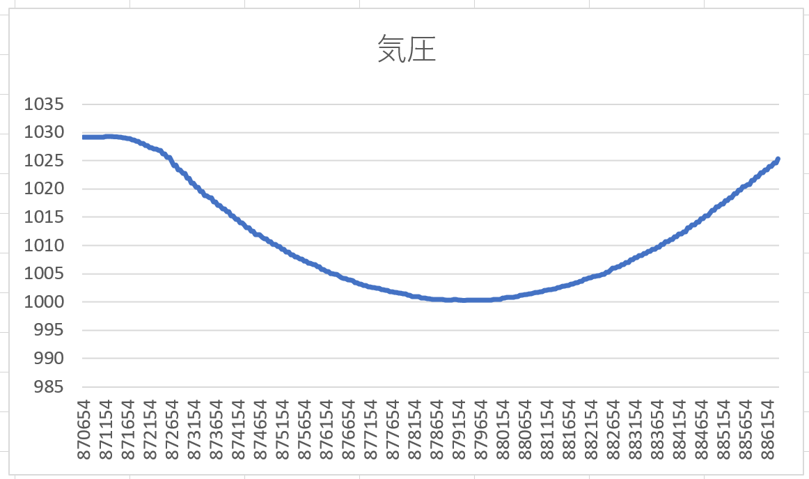
解析データ/気圧.png
