yumeno-robot/ROCKET-Spica/解析データ/温度取得データ全部.png

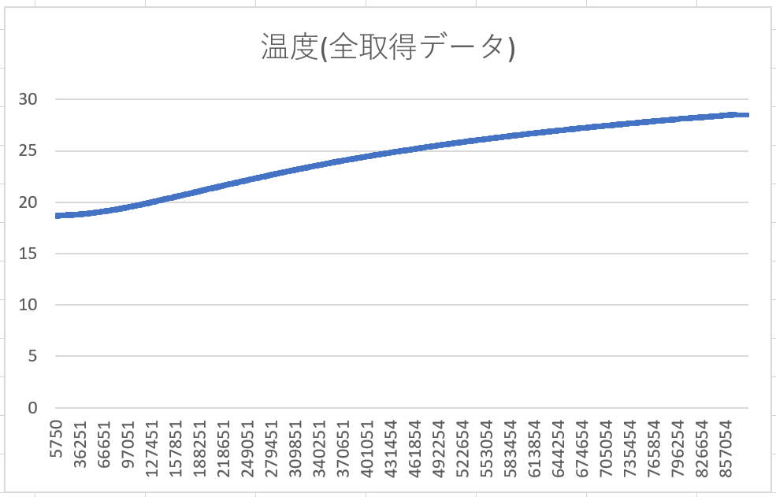
解析データ/温度取得データ全部.png
