yumeno-robot/ROCKET-Spica/解析データ/温度打ち上げ中.png

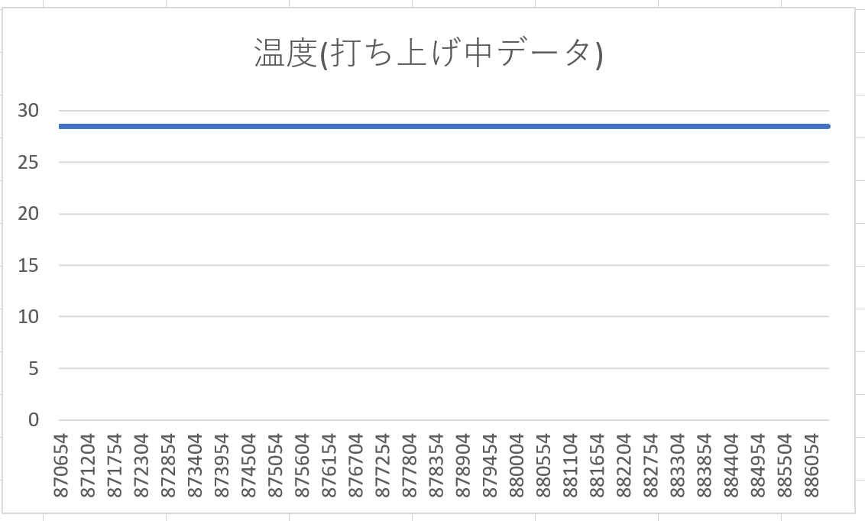
解析データ/温度打ち上げ中.png
