yumeno-robot/ROCKET-Spica/解析データ/湿度.png

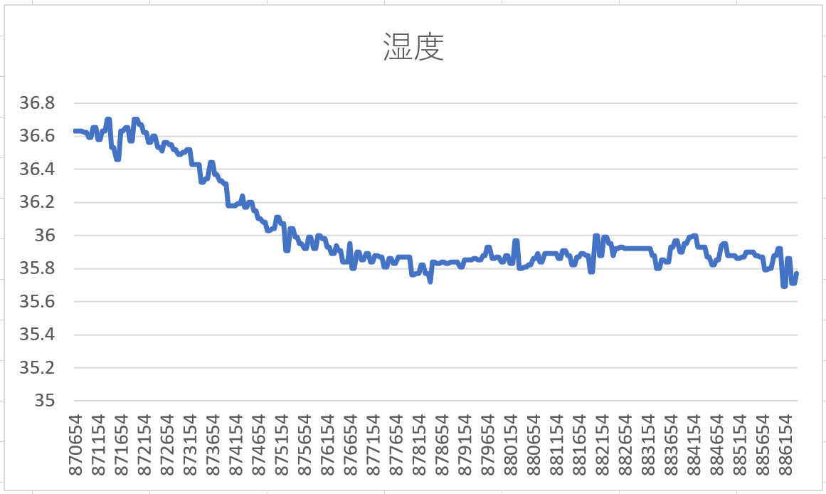
解析データ/湿度.png
