yumeno-robot/ROCKET-Spica/解析データ/燃焼終了時間の計算.png

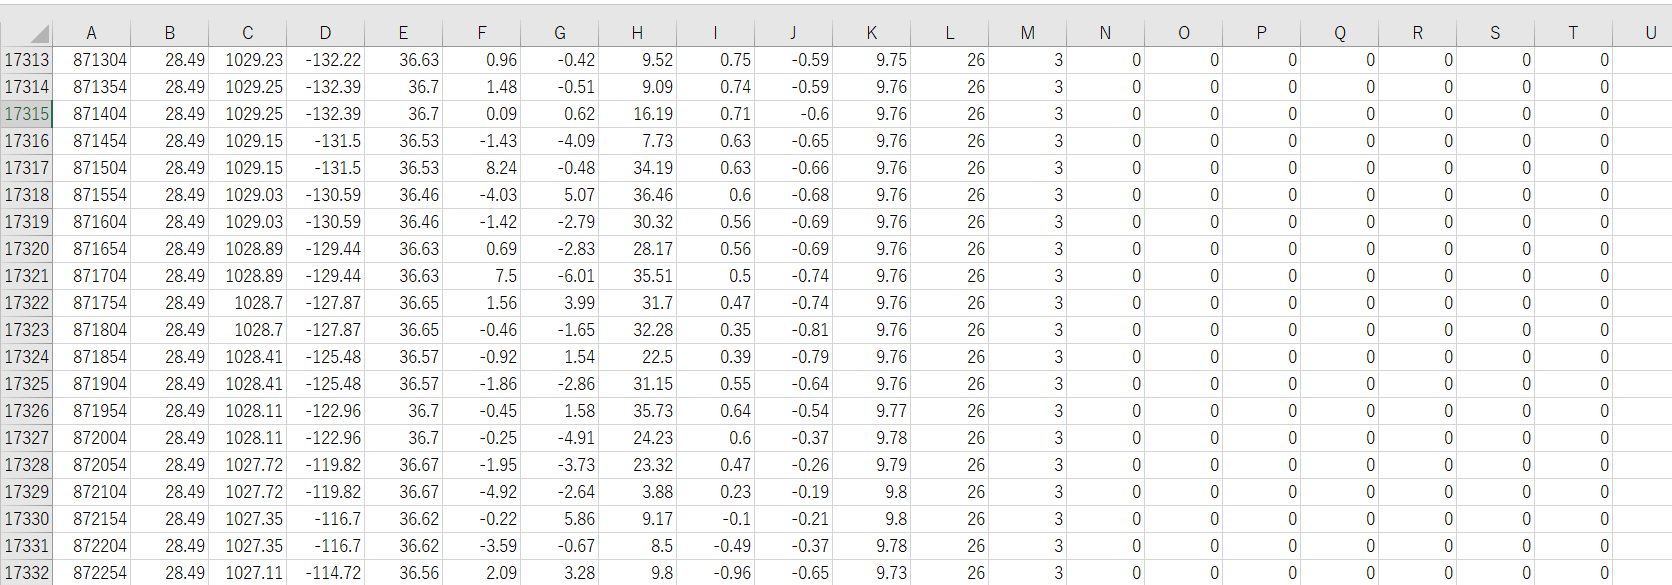
解析データ/燃焼終了時間の計算.png
