yumeno-robot/ROCKET-Spica/解析データ/高度.png

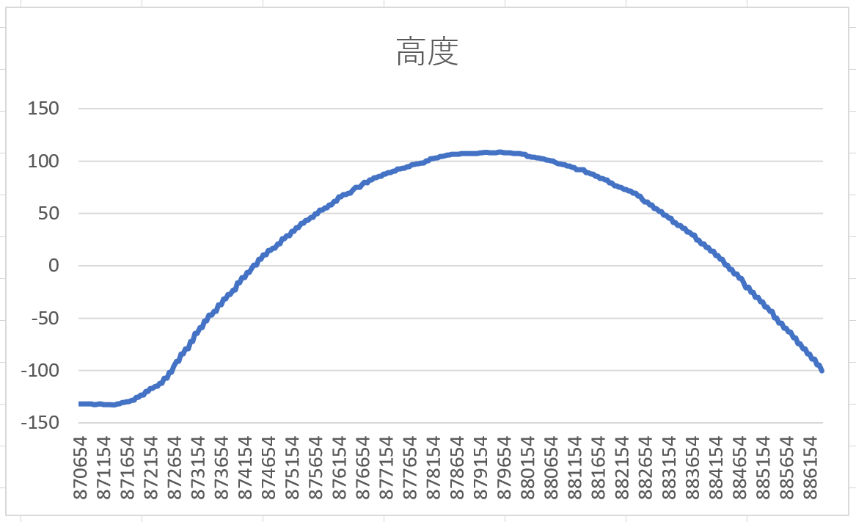
解析データ/高度.png
