yumeno-robot/ROCKET-Spica/回路図/Rocket_First-examination/Rocket_First-examination.pdf

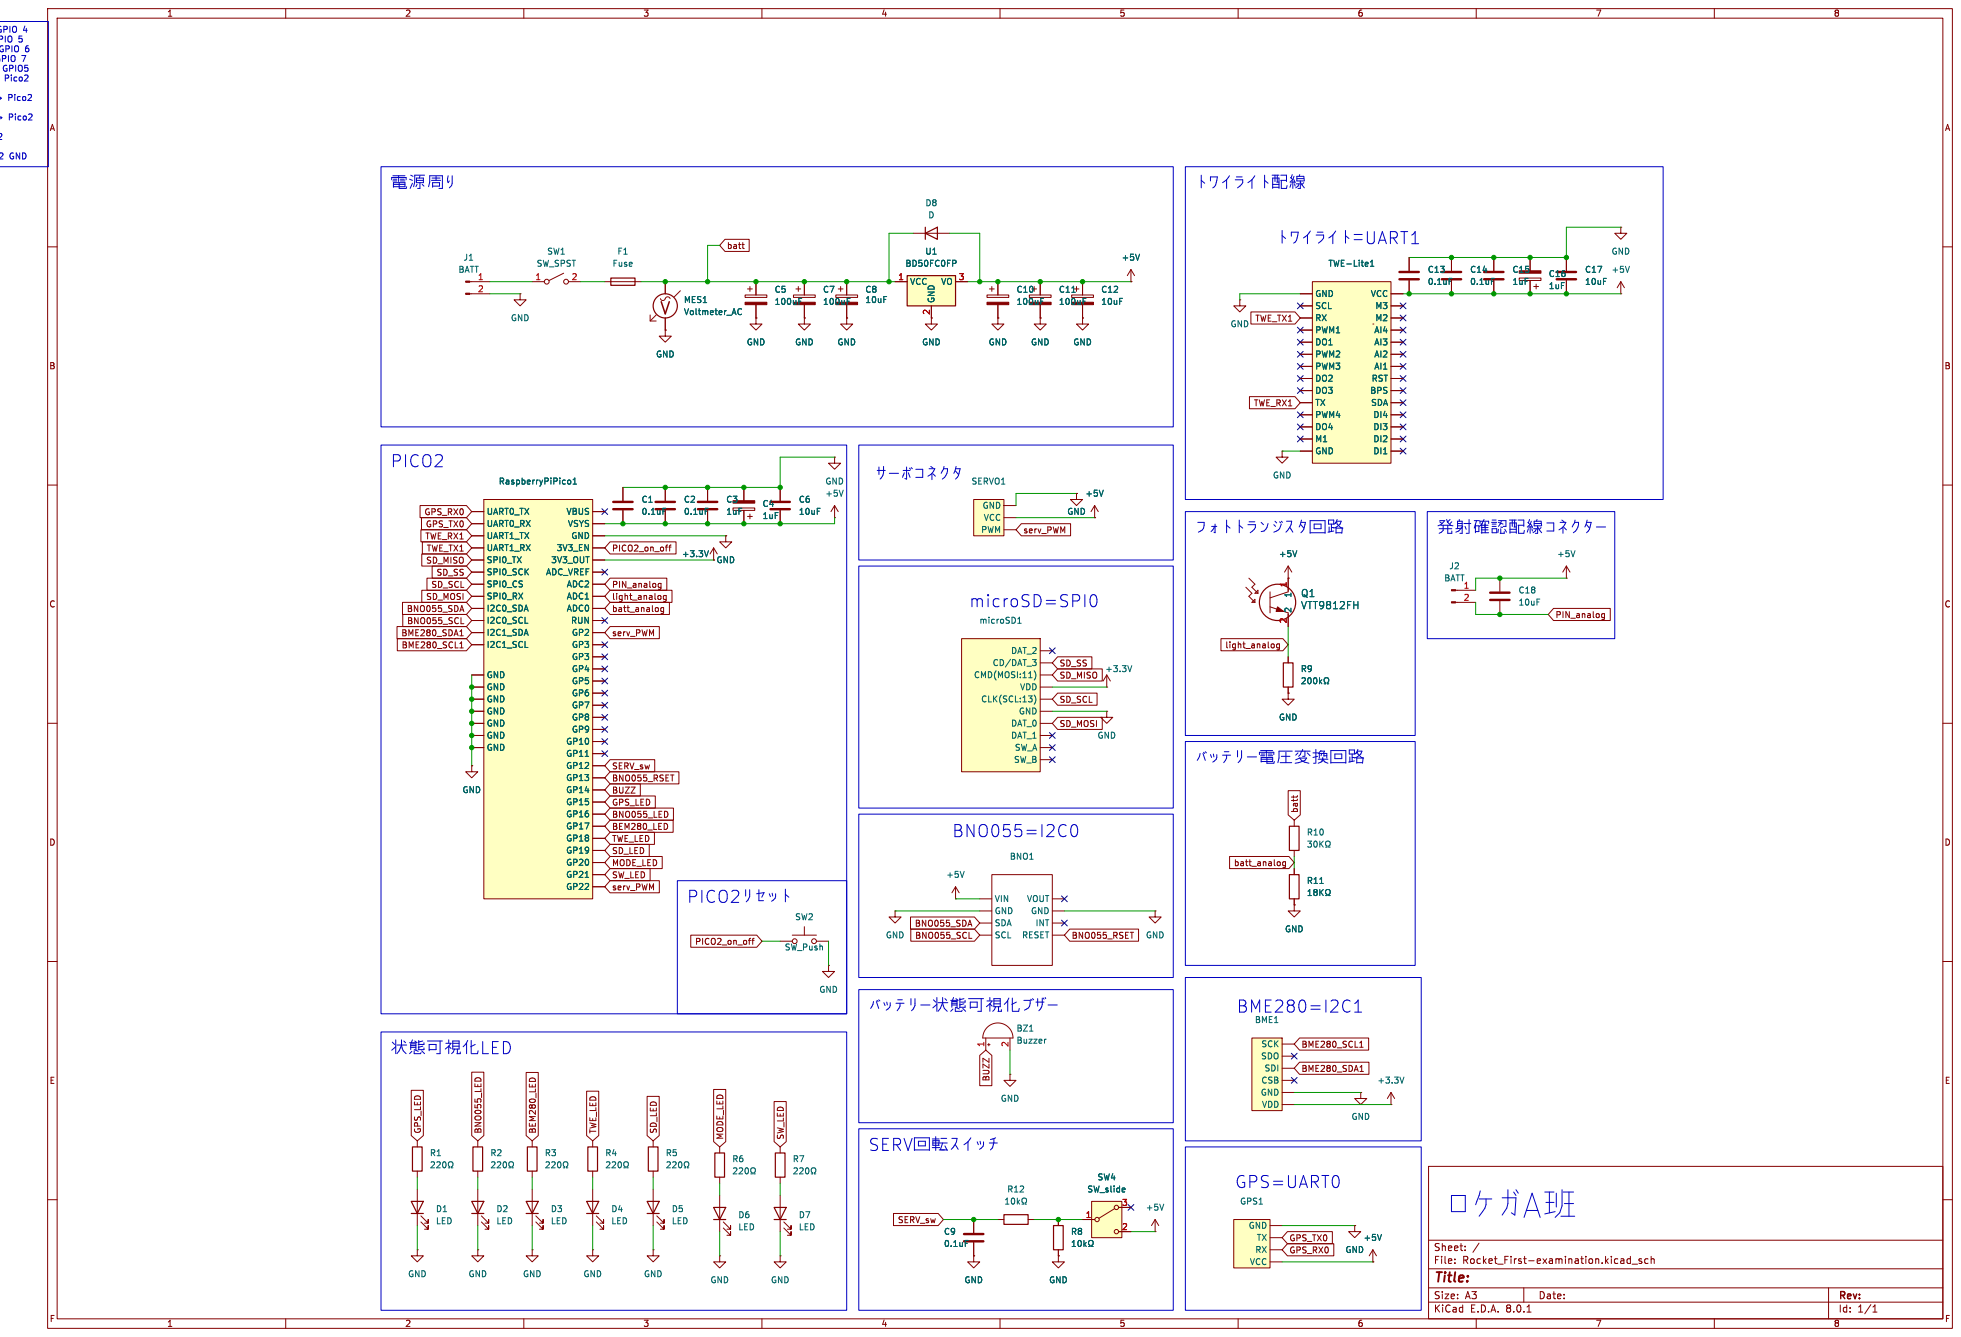
[picture p81: page 1]

SPI0_RX (MISO) þÿ!’GPIO 4 SPI0_CS (CSn) þÿ!’GPIO 5 SPI0_SCK (SCK) þÿ!’GPIO 6 SPI0_TX (MOSI) þÿ!’GPIO 7

þÿSD0«0ü0É CS þÿ!’Pico2 GPIO5
þÿSD0«0ü0É DI (MOSI) þÿ!’Pico2 GPIO7

þÿSD0«0ü0É DO (MISO) þÿ!’Pico2 GPIO4

þÿSD0«0ü0É CLK (SCK) þÿ!’Pico2 GPIO6

INT SCL RESET SDA
