yumeno-robot/ROCKET-Spica/回路図/MCU_circuits/MCU_circuits.kicad_sch

## KiCad design 回路図/MCU_circuits/MCU_circuits.kicad_sch (2025-12-05)

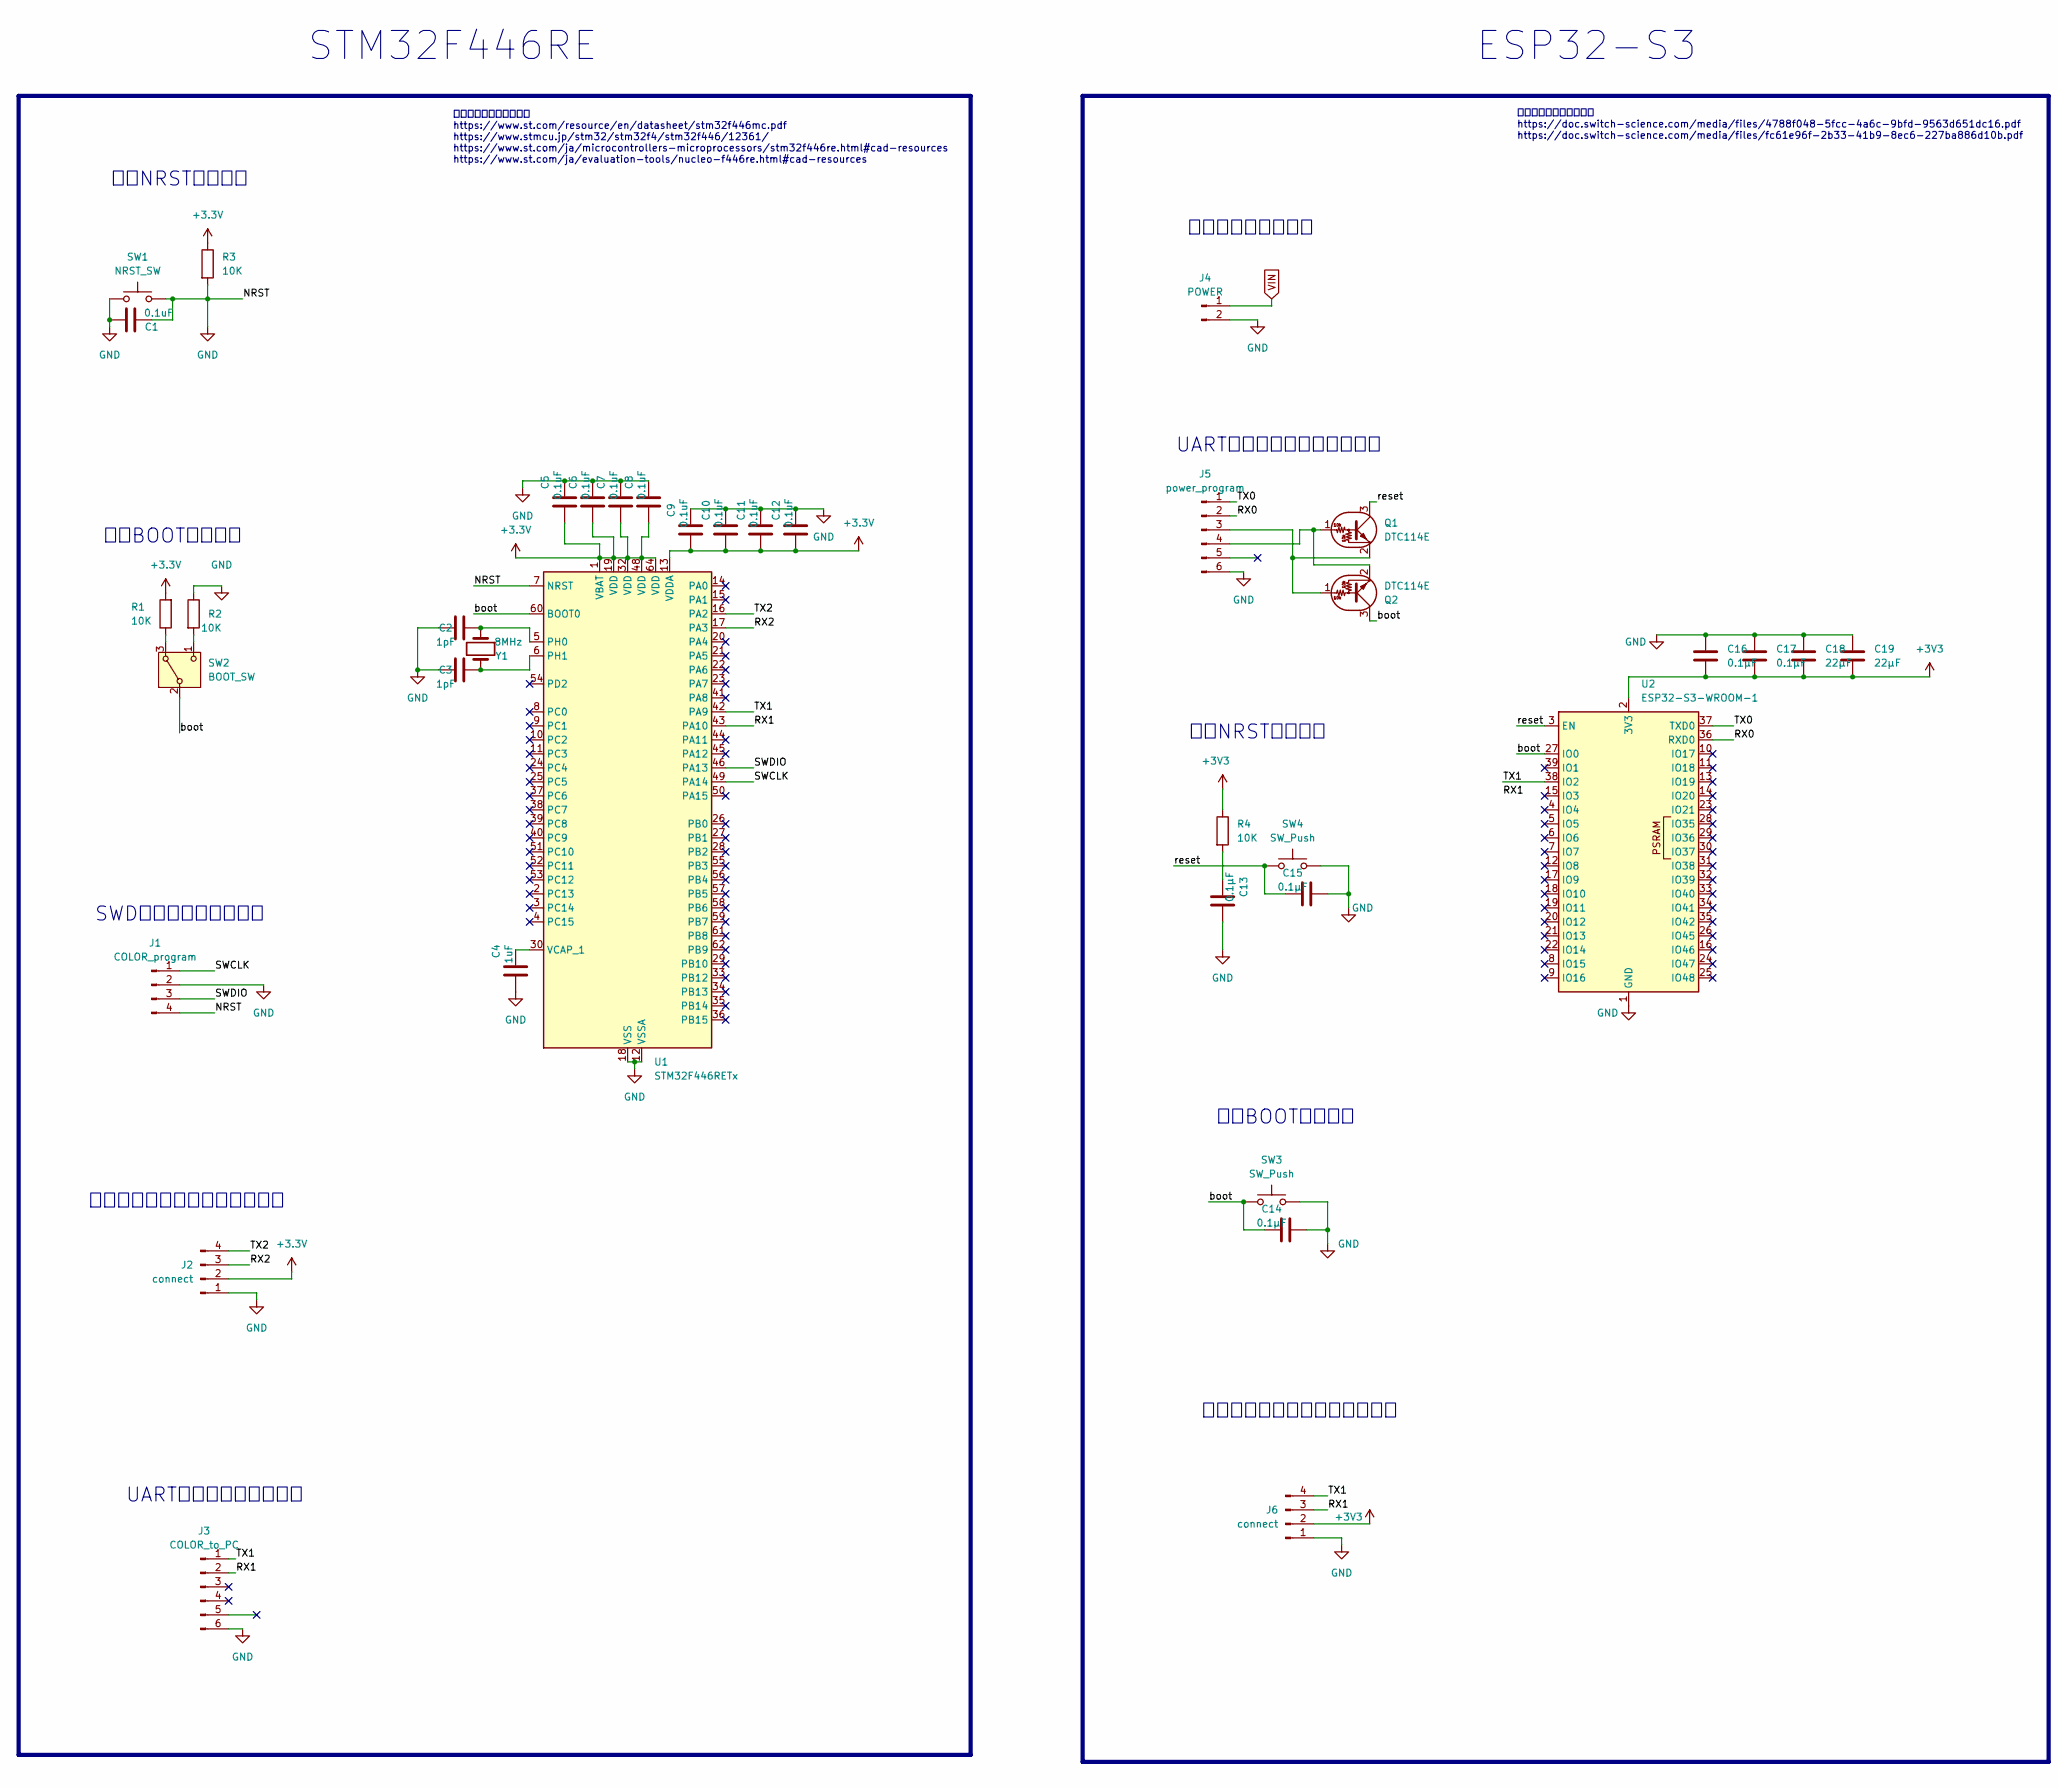
[picture p82: schematic MCU_circuits.kicad_sch, part in row 1, column 1]

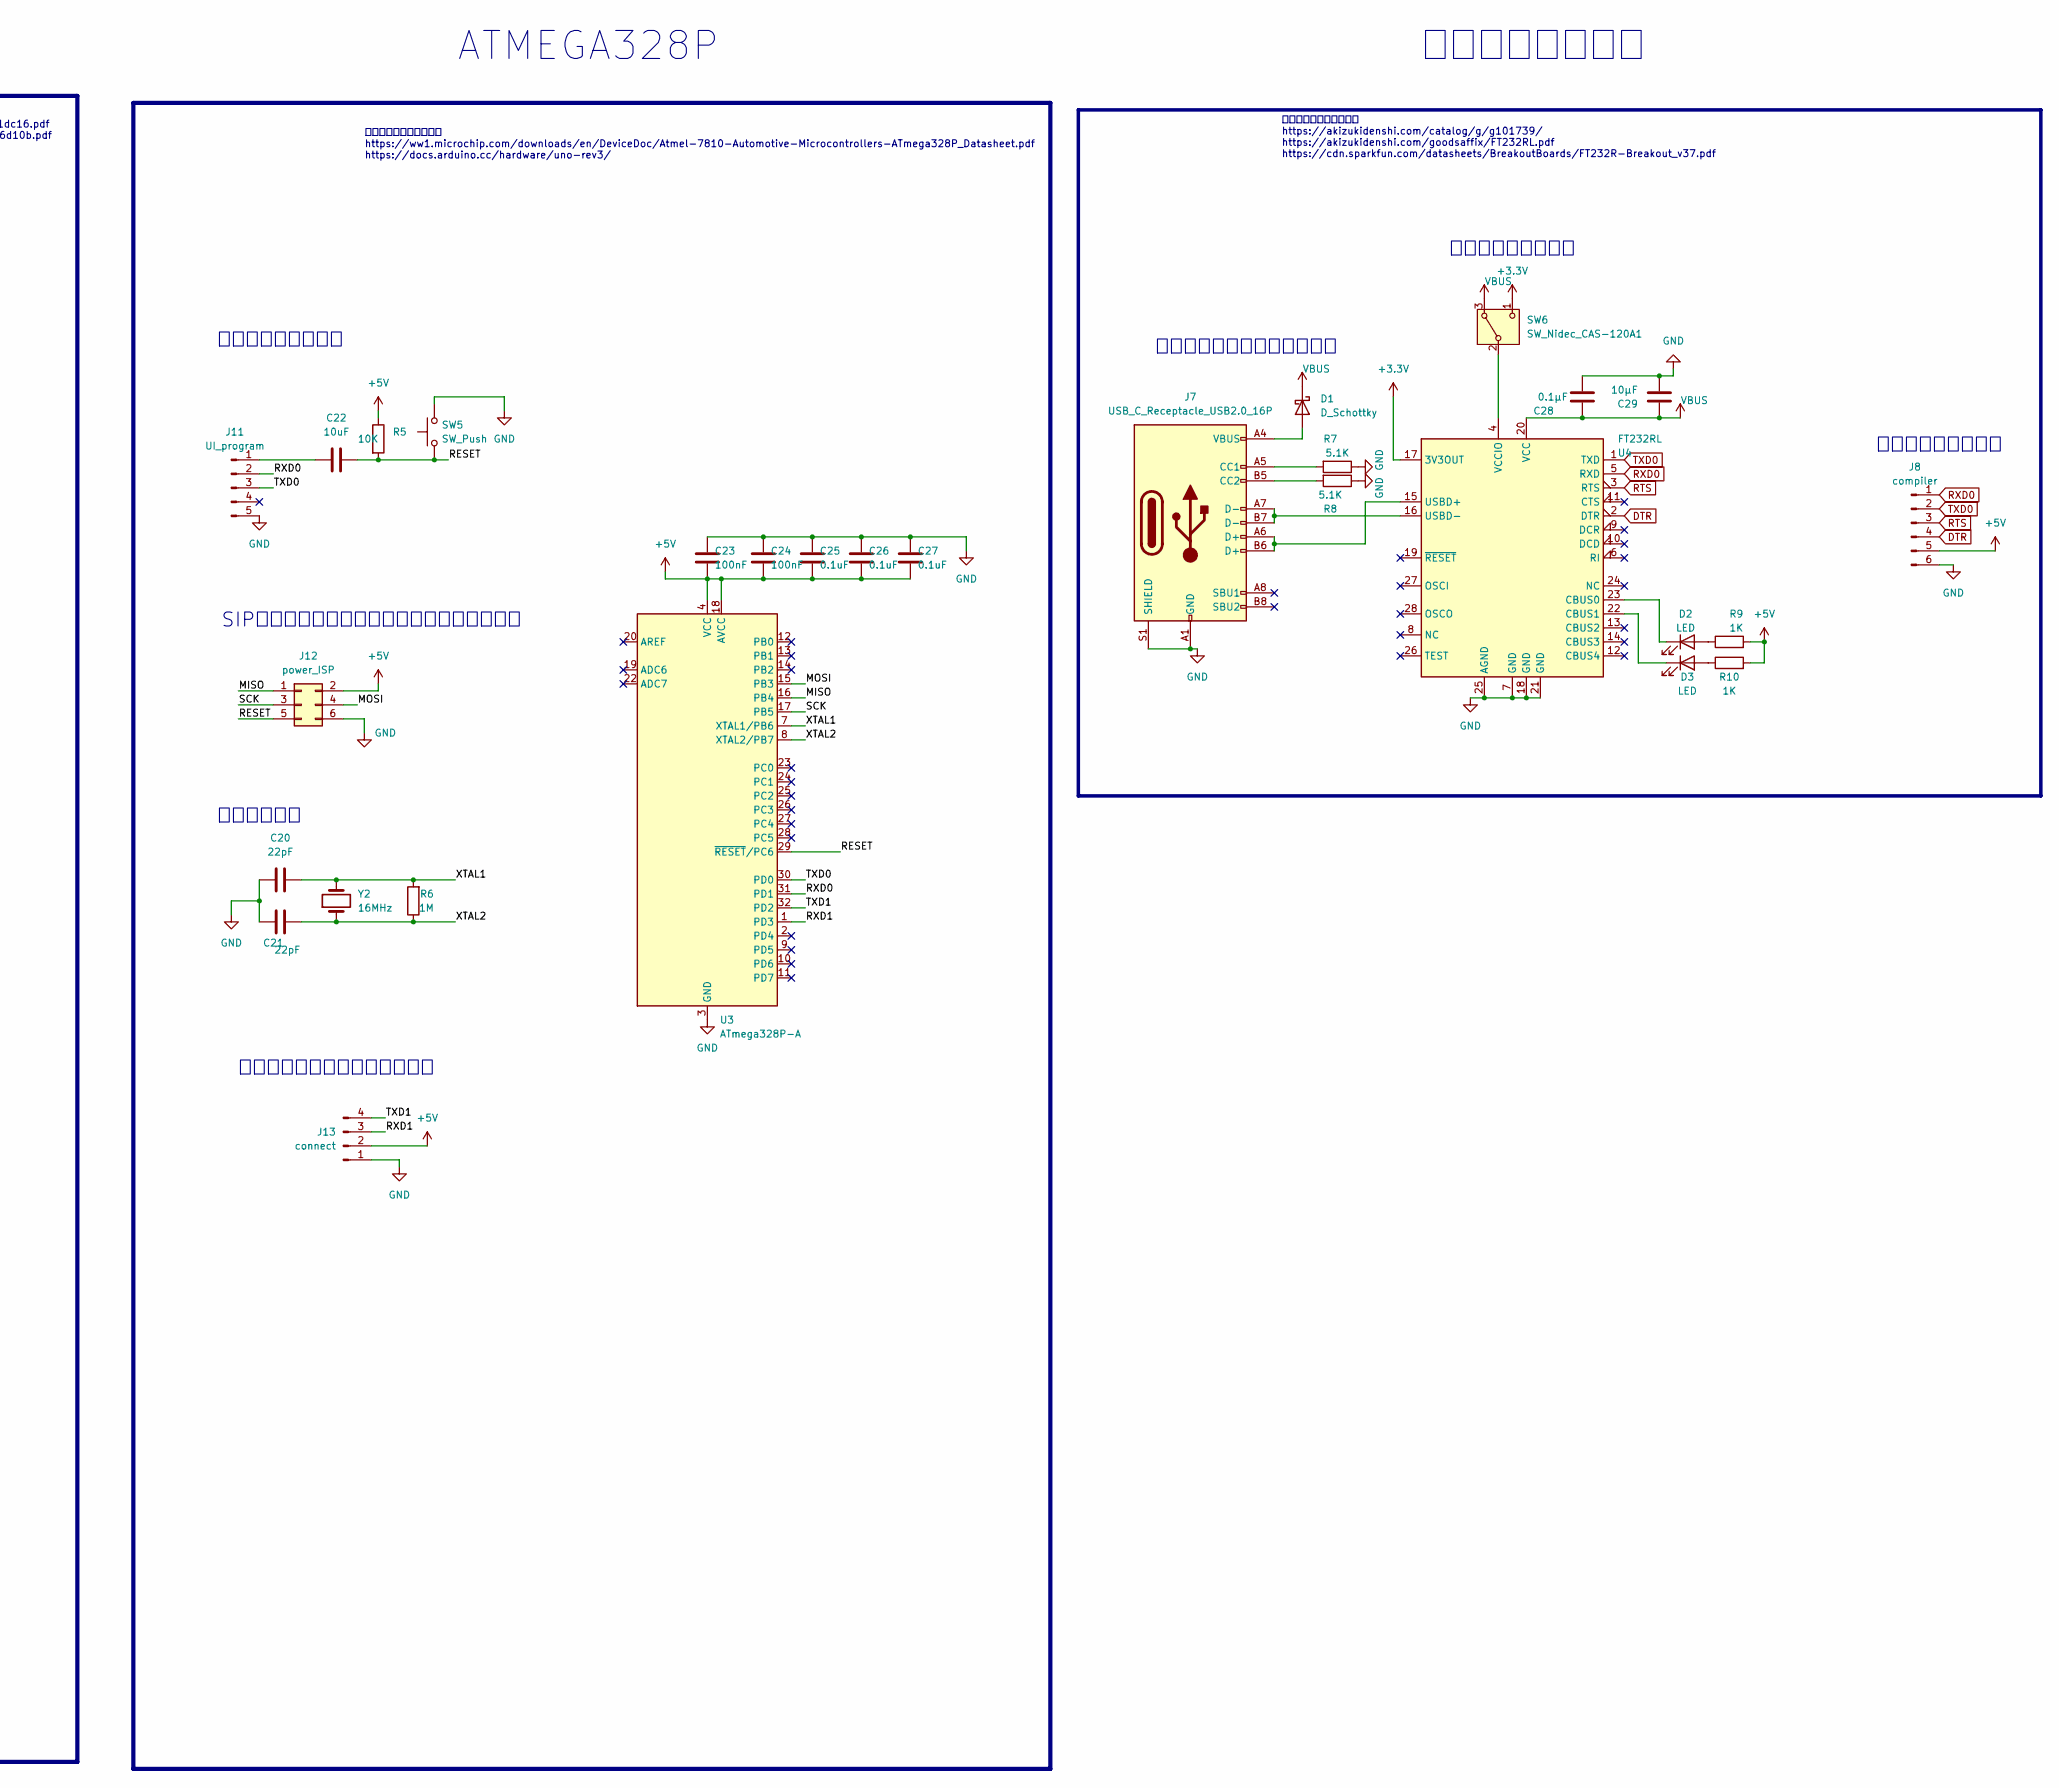
[picture p83: schematic MCU_circuits.kicad_sch, part in row 1, column 2]

Parts:
C1, C5, C6, C7, C8, C9, C10, C11, C12, C25, C26, C27: 0.1uF
C2, C3: 1pF
C4: 1uF
C13, C14, C15, C16, C17, C28: 0.1μF; C_0805_2012Metric_Pad1.18x1.45mm_HandSolder
C18, C19: 22μF; C_0805_2012Metric_Pad1.18x1.45mm_HandSolder
C20, C21: 22pF
C22: 10uF
C23, C24: 100nF
C29: 10μF; C_0805_2012Metric_Pad1.18x1.45mm_HandSolder
D1: D_Schottky; Nexperia_CFP3_SOD-123W
D2, D3: LED; LED_0805_2012Metric_Pad1.15x1.40mm_HandSolder
J1: COLOR_program
J2, J6, J13: connect
J3: COLOR_to_PC
J4: POWER
J5: power_program
J7: USB_C_Receptacle_USB2.0_16P; USB_C_Receptacle_HRO_TYPE-C-31-M-12
J8: compiler
J11: UI_program
J12: power_ISP
Q1, Q2: DTC114E; SOT-23-3
R1, R2, R3, R5: 10K
R4: 10K; R_0805_2012Metric_Pad1.20x1.40mm_HandSolder
R6: 1M
R7, R8: 5.1K; R_0805_2012Metric_Pad1.20x1.40mm_HandSolder
R9, R10: 1K; R_0805_2012Metric_Pad1.20x1.40mm_HandSolder
SW1: NRST_SW; SW_PUSH_6mm
SW2: BOOT_SW; Nidec_Copal_CAS-120A
SW3, SW4: SW_Push; SW_PUSH_6mm
SW5: SW_Push
SW6: SW_Nidec_CAS-120A1; Nidec_Copal_CAS-120A
U1: STM32F446RETx; LQFP-64_10x10mm_P0.5mm
U2: ESP32-S3-WROOM-1
U3: ATmega328P-A; TQFP-32_7x7mm_P0.8mm
U4: FT232RL; SSOP-28_5.3x10.2mm_P0.65mm
Y1: 8MHz
Y2: 16MHz

Connections:
+3.3V: C5.1, C6.1, C7.1, C8.1, C9.1, C10.1, C11.1, C12.1, J2.2, R1.2, R3.1, SW6.1 (C), U1.1 (VBAT), U1.13 (VDDA), U1.19 (VDD), U1.32 (VDD), U1.48 (VDD), U1.64 (VDD), U4.17 (3V3OUT)
+3V3: C16.2, C17.2, C18.2, C19.2, J6.2, R4.1, U2.2 (3V3)
+5V: C23.2, C24.2, C25.2, C26.2, C27.2, J8.5, J12.2, J13.2, R5.1, R9.2, R10.2, U3.4 (VCC), U3.6 (VCC), U3.18 (AVCC)
DTR: J8.4, U4.2 (DTR)
GND: C1.1, C1.2, C2.1, C3.1, C4.1, C5.2, C6.2, C7.2, C8.2, C9.2, C10.2, C11.2, C12.2, C13.2, C14.2, C15.2, C16.1, C17.1, C18.1, C19.1, C20.1, C21.1, C23.1, C24.1, C25.1, C26.1, C27.1, C28.2, C29.2, J1.2, J1.4, J2.1, J3.6, J4.2, J5.6, J6.1, J7.A1 (GND), J7.A12 (GND), J7.B1 (GND), J7.B12 (GND), J7.S1 (SHIELD), J8.6, J11.5, J12.6, J13.1, R2.1, R3.2, R7.1, R8.1, SW1.1, SW1.2, SW3.2, SW4.2, SW5.2, U1.7 (NRST), U1.12 (VSSA), U1.18 (VSS), U1.31 (VSS), U1.47 (VSS), U1.63 (VSS), U2.1 (GND), U2.40 (GND), U2.41 (GND), U3.3 (GND), U3.5 (GND), U3.21 (GND), U4.7 (GND), U4.18 (GND), U4.21 (GND), U4.25 (AGND)
MISO: J12.1, U3.16 (PB4)
MOSI: J12.4, U3.15 (PB3)
unnamed: C2.2, U1.5 (PH0), Y1.1
unnamed: C3.2, U1.6 (PH1), Y1.2
unnamed: C4.2, U1.30 (VCAP_1)
unnamed: C13.1, R4.2
unnamed: C22.1, J11.1
unnamed: D1.2 (A), J7.A4 (VBUS), J7.A9 (VBUS), J7.B4 (VBUS), J7.B9 (VBUS)
unnamed: D2.1 (K), U4.23 (CBUS0)
unnamed: D2.2 (A), R9.1
unnamed: D3.1 (K), U4.22 (CBUS1)
unnamed: D3.2 (A), R10.1
unnamed: J5.3, Q1.2 (E), Q2.1 (B)
unnamed: J5.4, Q1.1 (B), Q2.2 (E)
unnamed: J7.A5 (CC1), R7.2
unnamed: J7.A6 (D+), J7.B6 (D+), U4.15 (USBD+)
unnamed: J7.A7 (D-), J7.B7 (D-), U4.16 (USBD-)
unnamed: J7.B5 (CC2), R8.2
unnamed: R1.1, SW2.3 (A)
unnamed: R2.2, SW2.1 (C)
unnamed: SW6.2 (B), U4.4 (VCCIO)
RTS: J8.3, U4.3 (RTS)
RX0: J5.2, U2.36 (RXD0)
RX1: J3.2, J6.3, U1.43 (PA10)
RX2: J2.3, U1.17 (PA3)
RXD0: J8.1, J11.2, U3.31 (PD1), U4.5 (RXD)
RXD1: J13.3, U3.1 (PD3)
SCK: J12.3, U3.17 (PB5)
SWCLK: J1.1, U1.49 (PA14)
SWDIO: J1.3, U1.46 (PA13)
TX0: J5.1, U2.37 (TXD0)
TX1: J3.1, J6.4, U1.42 (PA9), U2.38 (IO2)
TX2: J2.4, U1.16 (PA2)
TXD0: J8.2, J11.3, U3.30 (PD0), U4.1 (TXD)
TXD1: J13.4, U3.32 (PD2)
VBUS: C28.1, C29.1, D1.1 (K), SW6.3 (A), U4.20 (VCC)
VIN: J4.1
XTAL1: C20.2, R6.2, U3.7 (XTAL1/PB6), Y2.2
XTAL2: C21.2, R6.1, U3.8 (XTAL2/PB7), Y2.1
boot: C14.1, Q2.3 (C), SW2.2 (B), SW3.1, U1.60 (BOOT0), U2.27 (IO0)
reset: C15.1, C22.2, J12.5, Q1.3 (C), R5.2, SW4.1, SW5.1, U2.3 (EN), U3.29 (~RESET/PC6)

Notes on the sheet:
電源供給コネクター
メインマイコン通信コネクター
シリアル変換器 書き込み用
ESP32-S3
クロック回路
データーシートと回路図 https://akizukidenshi.com/catalog/g/g101739/ https://akizukidenshi.com/goodsaffix/FT232RL.pdf https://cdn.sparkfun.com/datasheets/BreakoutBoards/FT232R-Breakout_v37.pdf
SWD書き込みコネクター
手動NRST制御回路
レベル変換スイッチ
手動BOOT制御回路
データーシートと回路図 https://ww1.microchip.com/downloads/en/DeviceDoc/Atmel-7810-Automotive-Microcontrollers-ATmega328P_Datasheet.pdf https://docs.arduino.cc/hardware/uno-rev3/
STM32F446RE
書き込みコネクター
データーシートと回路図 https://doc.switch-science.com/media/files/4788f048-5fcc-4a6c-9bfd-9563d651dc16.pdf https://doc.switch-science.com/media/files/fc61e96f-2b33-41b9-8ec6-227ba886d10b.pdf
UART書き込みコネクター
データーシートと回路図 https://www.st.com/resource/en/datasheet/stm32f446mc.pdf https://www.stmcu.jp/stm32/stm32f4/stm32f446/12361/ https://www.st.com/ja/microcontrollers-microprocessors/stm32f446re.html#cad-resources https://www.st.com/ja/evaluation-tools/nucleo-f446re.html#cad-resources
書き込みコネクター
UART自動書き込みコネクター
シリアル変換基板
SIPコネクター（ブート書き込みコネクター）
ATMEGA328P
