yumeno-robot/ROCKET-Spica/回路図/Rocket_CDR_1/Rocket_CDR_1.kicad_sch

## KiCad design 回路図/Rocket_CDR_1/Rocket_CDR_1.kicad_sch (2025-12-05)

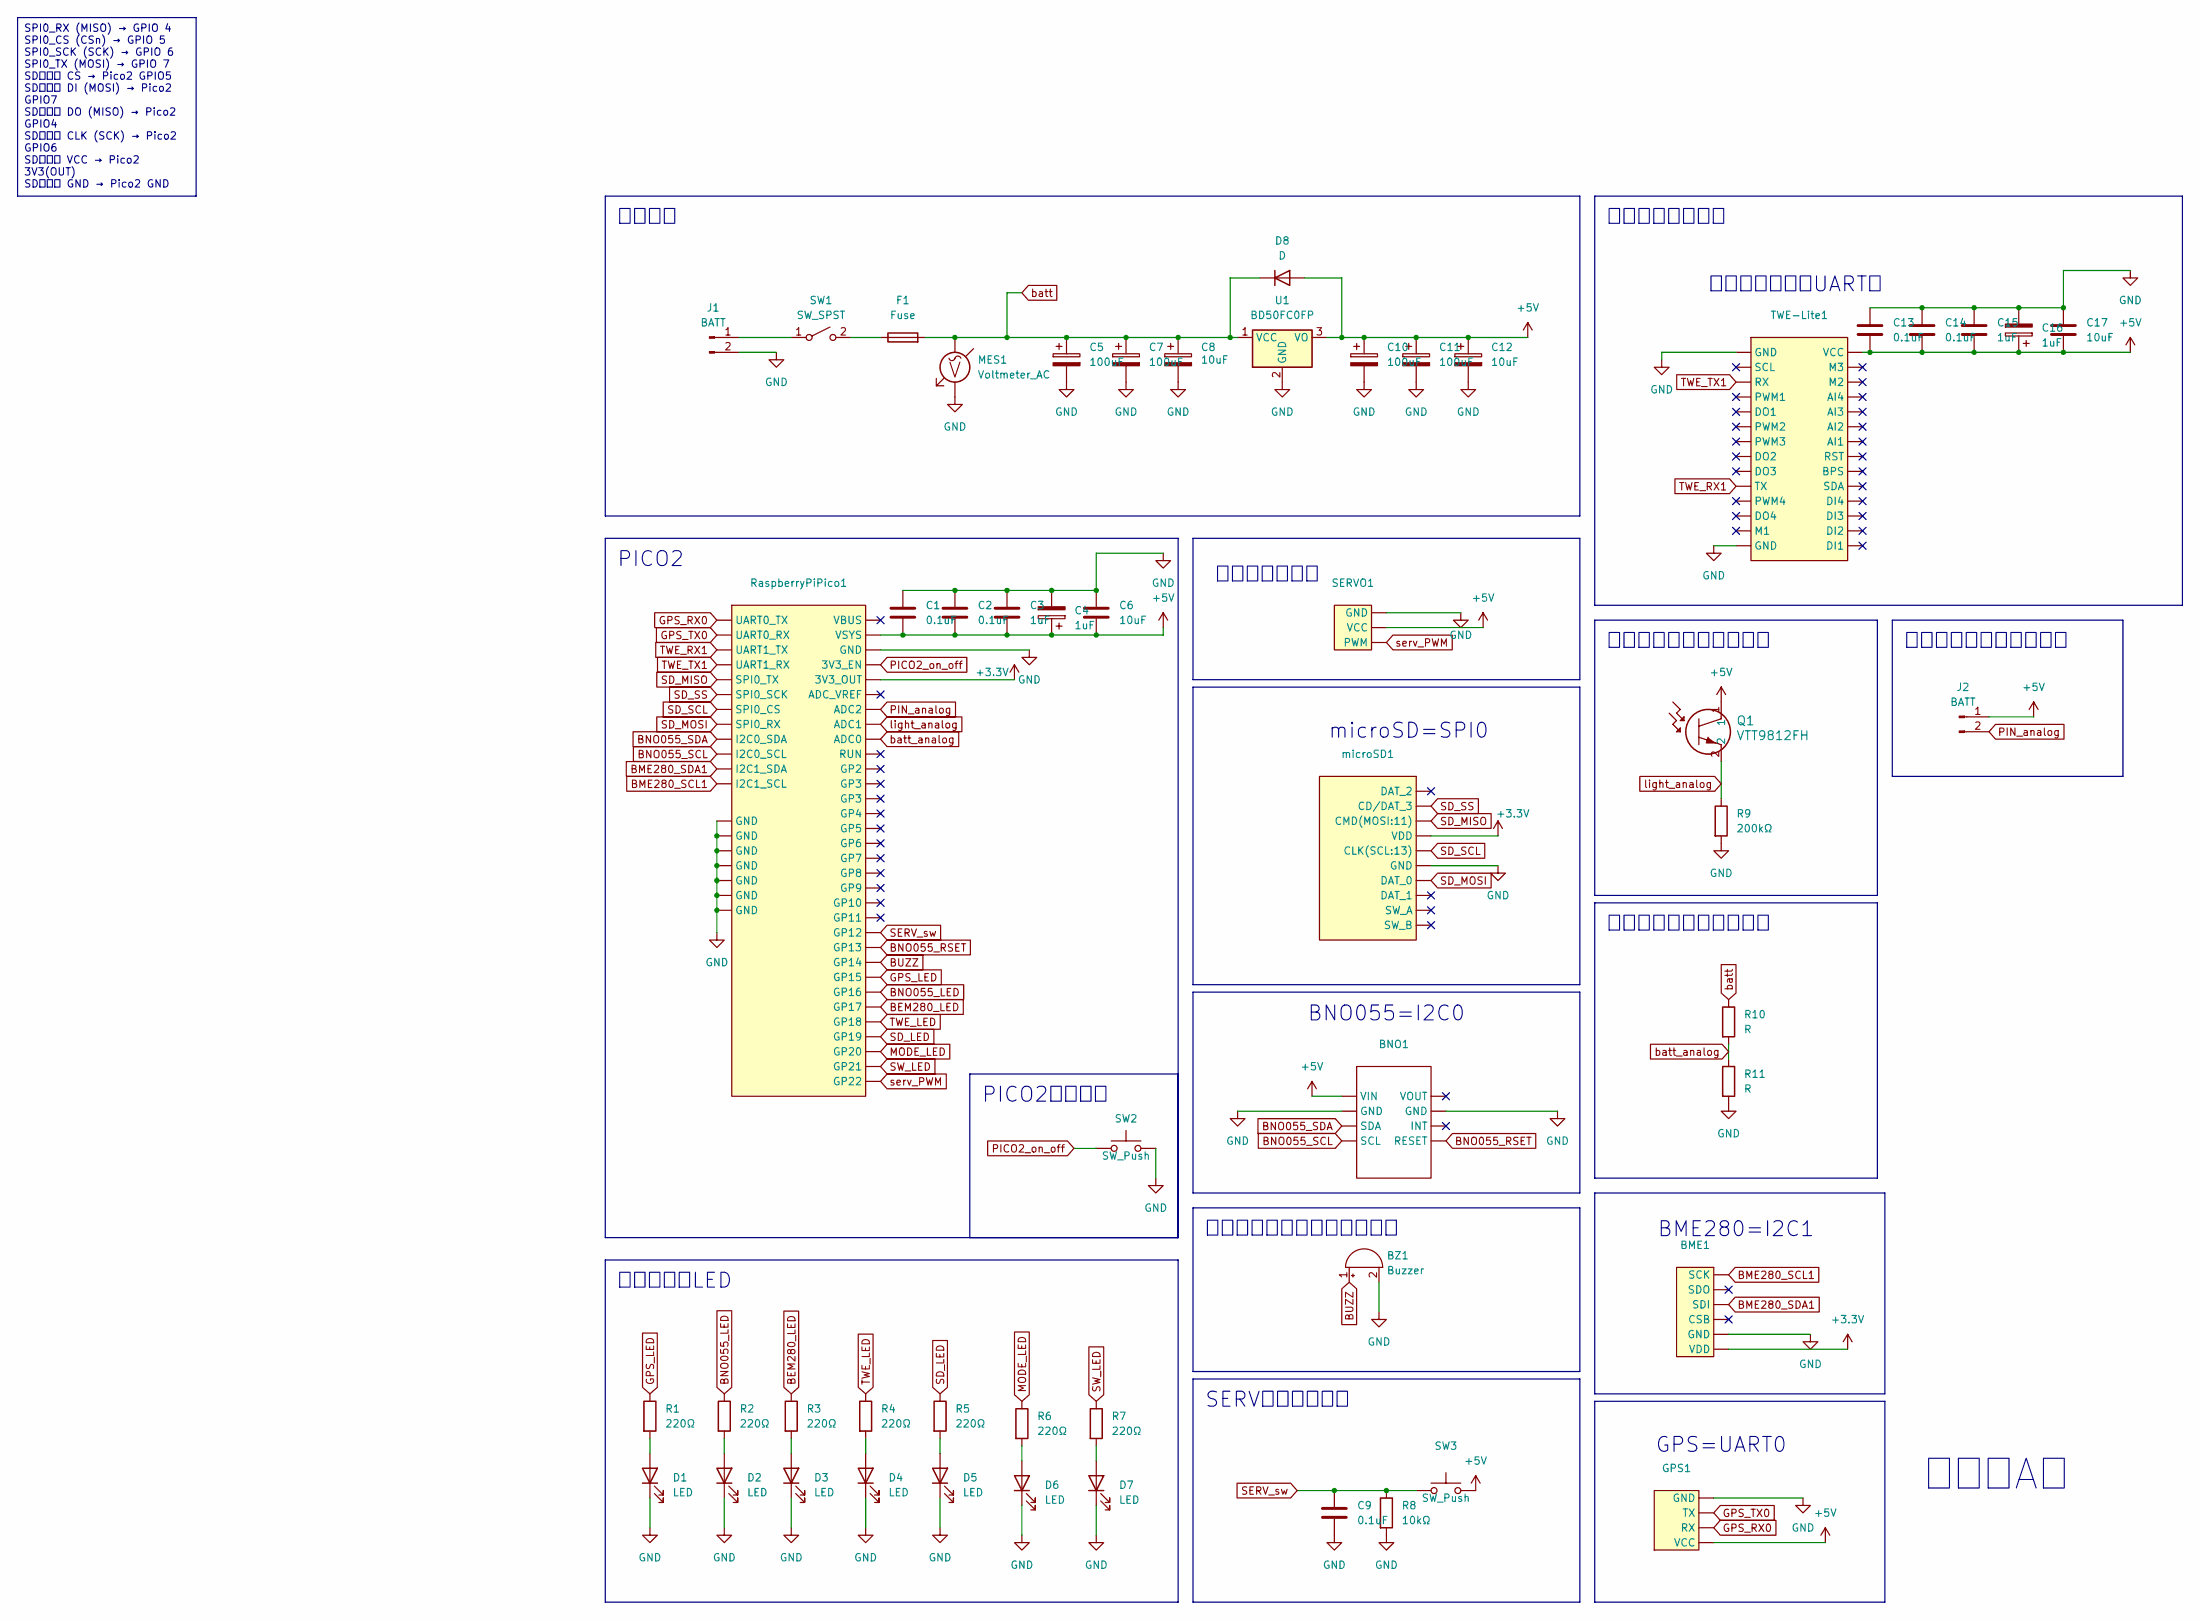
[picture p84: schematic Rocket_CDR_1.kicad_sch]

Parts:
BME1: (no value)
BNO1: (no value)
BZ1: Buzzer
C1, C2, C9, C13, C14: 0.1uF
C3, C4, C15, C16: 1uF
C5, C7, C10, C11: 100uF
C6, C8, C12, C17: 10uF
D1, D2, D3, D4, D5, D6, D7: LED
D8: D
F1: Fuse
GPS1: (no value)
J1, J2: BATT
MES1: Voltmeter_AC
Q1: VTT9812FH; PHOTOTR_VTT_T-1-3/4_EXT
R1, R2, R3, R4, R5, R6, R7: 220Ω
R8: 10kΩ
R9: 200kΩ
R10, R11: R
RaspberryPiPico1: (no value)
SERVO1: (no value)
SW1: SW_SPST
SW2, SW3: SW_Push
TWE-Lite1: (no value)
U1: BD50FC0FP; TO-252-2
microSD1: (no value)

Connections:
+3.3V: BME1., RaspberryPiPico1., microSD1.
+5V: BNO1., C1.2, C2.2, C3.2, C4.1, C6.2, C10.1, C11.1, C12.1, C13.2, C14.2, C15.2, C16.1, C17.2, D8.2 (A), GPS1., J2.1, Q1.1, RaspberryPiPico1., SERVO1., SW3.2, TWE-Lite1., U1.3 (VO)
BEM280_LED: R3.1, RaspberryPiPico1.
BME280_SCL1: BME1., RaspberryPiPico1.
BME280_SDA1: BME1., RaspberryPiPico1.
BNO055_LED: R2.1, RaspberryPiPico1.
BNO055_RSET: BNO1., RaspberryPiPico1.
BNO055_SCL: BNO1., RaspberryPiPico1.
BNO055_SDA: BNO1., RaspberryPiPico1.
BUZZ: BZ1.1 (+), RaspberryPiPico1.
GND: BME1., BNO1., BZ1.2 (-), C1.1, C2.1, C3.1, C4.2, C5.2, C6.1, C7.2, C8.2, C9.2, C10.2, C11.2, C12.2, C13.1, C14.1, C15.1, C16.2, C17.1, D1.1 (K), D2.1 (K), D3.1 (K), D4.1 (K), D5.1 (K), D6.1 (K), D7.1 (K), GPS1., J1.2, MES1.2, R8.2, R9.2, R11.2, RaspberryPiPico1., SERVO1., SW2.2, TWE-Lite1., U1.2 (GND), microSD1.
GPS_LED: R1.1, RaspberryPiPico1.
GPS_RX0: GPS1., RaspberryPiPico1.
GPS_TX0: GPS1., RaspberryPiPico1.
MODE_LED: R6.1, RaspberryPiPico1.
unnamed: D1.2 (A), R1.2
unnamed: D2.2 (A), R2.2
unnamed: D3.2 (A), R3.2
unnamed: D4.2 (A), R4.2
unnamed: D5.2 (A), R5.2
unnamed: D6.2 (A), R6.2
unnamed: D7.2 (A), R7.2
unnamed: F1.1, SW1.2 (B)
unnamed: J1.1, SW1.1 (A)
PICO2_on_off: RaspberryPiPico1., SW2.1
PIN_analog: J2.2, RaspberryPiPico1.
SD_LED: R5.1, RaspberryPiPico1.
SD_MISO: RaspberryPiPico1., microSD1.
SD_MOSI: RaspberryPiPico1., microSD1.
SD_SCL: RaspberryPiPico1., microSD1.
SD_SS: RaspberryPiPico1., microSD1.
SERV_sw: C9.1, R8.1, RaspberryPiPico1., SW3.1
SW_LED: R7.1, RaspberryPiPico1.
TWE_LED: R4.1, RaspberryPiPico1.
TWE_RX1: RaspberryPiPico1., TWE-Lite1.
TWE_TX1: RaspberryPiPico1., TWE-Lite1.
batt: C5.1, C7.1, C8.1, D8.1 (K), F1.2, MES1.1, R10.1, U1.1 (VCC)
batt_analog: R10.2, R11.1, RaspberryPiPico1.
light_analog: Q1.2, R9.1, RaspberryPiPico1.
serv_PWM: RaspberryPiPico1., SERVO1.

Notes on the sheet:
PICO2
発射確認配線コネクター
SPI0_RX (MISO) → GPIO 4 SPI0_CS (CSn) → GPIO 5 SPI0_SCK (SCK) → GPIO 6 SPI0_TX (MOSI) → GPIO 7 SDカード CS → Pico2 GPIO5 SDカード DI (MOSI) → Pico2 GPIO7 SDカード DO (MISO) → Pico2 GPIO4 SDカード CLK (SCK) → Pico2 GPIO6 SDカード VCC → Pico2 3V3(OUT) SDカード GND → Pico2 GND
フォトトランジスタ回路
状態可視化LED
バッテリー電圧変換回路
トワイライト配線
電源周り
バッテリー状態可視化ブザー
SERV回転スイッチ
PICO2リセット
トワイライト＝UART１
microSD=SPI0
GPS=UART0
BNO055=I2C0
ロケガA班
BME280=I2C1
サーボコネクタ
