yumeno-robot/ROCKET-Spica/A班電装プログラム/rocket/rocket.ino

#include <SPI.h>
#include <SD.h>

//SDカード書き込み必須グローバル変数
const int Data_Nunber_Of_Pieces = 20;
volatile double writeData[Data_Nunber_Of_Pieces];
volatile bool writeRequest = false;
volatile int writeIndex = 0;    // 現在の書き込み位置

//センサー実装可視化変数
volatile bool error_SD = true;
bool error_BNO055 = true;
bool error_BNE280 = true;
bool error_GPS = true;

//デバック変数
//bool debug = true;    //serial.printをloop関数内でやるか否なか
bool debug = false;     //serial.printをloop関数内でやるか否なか

//トワイライトによるフラグ
bool motor_flag = false;
bool motor_forced_open = false;


//時間監視変数(アルゴリズム用)
unsigned long prevMillis = 0;
const unsigned long interval = 10;// [ms] ループ周期（10msごとに監視）

// 加速度Z監視用(アルゴリズム用)
int overGcount = 0;
const float ACCEL_THRESHOLD = 19.6;// 2G = 9.8 * 2 [m/s^2]
const int CONTINUE_TIME_MS = 200;// 継続時間 [ms]___________________________________________________________________
const int REQUIRED_COUNT = CONTINUE_TIME_MS / interval;

// 離床検知フラグ(アルゴリズム用)
bool liftOffDetected = false;  // 離床検知済みか
float ACCEL_THRESHOLD_HIGH = 19.6;// 2G [m/s²]               加速ナウか否か閾値
float ACCEL_THRESHOLD_LOW  = 9.8;// 閾値下回り判定（自由落下近似）　加速度が下回ったか閾値

// 状態管理用フラグ(アルゴリズム用)
bool accelOver2G = false;
bool burnEndFlag = false;

//フライトピン監視用フラグ(SDカード用)
bool Write_Sd_FirstTIME = false;
bool Flight = false;
//double flight_time;

bool Launch_completed = false;//発射が完全にOK出たらtrueになる
unsigned long Launch_completion_time;
bool First_Launch_completion = false;//一回だけ時間を書けるようにするやつ

unsigned long Release_completion_time;
bool First_Release_completion = false;//一回だけ時間を書けるようにするやつ


unsigned long Release_Signal_time;
bool First_Release_Signal = false;//一回だけ時間を書けるようにするやつ


//書き込み速度が読み込み速度がより低下した場合、値がずれていくことがある。それを防ぐためのフラグ。
bool SD_WRITE_NOW = false;






void setup() {
  delay(4000);
  Serial.begin(115200);

  Setup_other_pin();

  Setup_SD();
  File dataFile = SD.open("datalog.txt", FILE_WRITE);
  delay(50);
  dataFile.print("2025年御宿共同打ち上げ実験　AチームログSTART");
  dataFile.println();
  dataFile.print("経過時間,温度,気圧,高度,湿度,加速度x,加速度y,加速度z,重力x,重力y,重力z,温度,ジャイロ,加速度,地磁気,緯度,経度,高度,離床時間,解放信号出力時間,解放検出時間");
  dataFile.println();
  dataFile.flush();
  dataFile.close();

  servo(0);         // 閉じる

  Setup_GPS();
  delay(500);

  Setup_BNO055();
  Setup_BME280();
  Setup_TWELITE();


  Read_GPS_time();

  buzz_start();
  servo(0);//閉じる
}

void setup1() {
}

void loop() {
  //______________デバック用______________________________________
  if (debug) {
    Serial.println("start__________________________________");
  }





  //______________全センサー値の取得_______________________________
  //Read_Twilight();
  Read_BME280();
  Read_BNO055();
  Read_GPS();
  controlMotor();





  //___________以下にアルゴリズム追加____________________________


  //prevMillis=前回処理を実行した時刻
  //interval=どのくらいの間隔で処理をしたいか200ミリ秒だから20回分※20ミリ秒に一度だけ実行する
  unsigned long now = millis();
  if (now - prevMillis >= interval) {
    prevMillis = now;



    //_____________________________________________________________________________________以下離床検出プログラム_____________________________________________________________________________________

    Read_filtepin();//フライトピンの確認

    if (Flight) { //もしフライトピンが抜けていたら以下を実行
      Serial.println("フライトピン抜けてる");


      // ---- 加速度Zの判定 ----
      float accelZ = Return_AccelZ();  // Z軸加速度を取得
      if (accelZ > ACCEL_THRESHOLD) {//______読んだ値(accelZ)が19.8m/s^2(ACCEL_THRESHOLD)を越しているか否か。越してたら＋＋でなければリセット
        overGcount++;
      } else {
        overGcount = 0;
      }
      /*
        加速度Zが 19.6 m/s² (≒2G) を超えると「上昇中」とみなしてカウントを増やします。
        超えなかったらリセットします。
        つまり、「連続して2G以上が続いたら本当に上昇している」と判断します。
      */



      //_______________________________________________________________以下条件達成の場合減速装置放出機構動作プログラム___________________________________________________________________________
      if (overGcount >= REQUIRED_COUNT) {// 「ジャイロが連続して増加している」場合離床したと判断する。
        Launch_completed = true;
        if (!First_Launch_completion) {
          Serial.println("離床完了");
          Serial.println("離床完了。");
          Serial.println("離床完了。");
          Serial.println("離床完了。");
          Serial.println("離床完了。");
          Serial.println("離床完了。");
          Serial.println("離床完了。");
          Serial.println("離床完了。");
          Serial.println("離床完了。");
          Launch_completion_time = millis();
          First_Launch_completion = true;
        }
      }




      if (Launch_completed) {
        float z = Return_AccelZ();

        // 1. Z軸が一度 2G を超えたかチェック
        if (z >= ACCEL_THRESHOLD_HIGH) {
          accelOver2G = true;// 2G超えたら「燃焼中」と判定
        }

        // 2. 2G超過済みなら、閾値を下回ったかチェック
        if (accelOver2G && z <= ACCEL_THRESHOLD_LOW) {
          burnEndFlag = true;       // 2Gを超えたあとに9m/s²以下になった → 燃焼終了
          //accelOver2G = false;      // 状態リセット（必要に応じて）
        }


        if (accelOver2G && !burnEndFlag) {
          Serial.println("燃焼中");
        } else if (accelOver2G && burnEndFlag) {
          Serial.println("燃焼終了");
        }


      }
      /*
              連続して「加速度が2G超え」た場合に、
              「燃焼終了」を確認します。
              もし燃焼が終わった（burnEndFlag == true）なら、「解放します！！」と出力。
      */





      if ((burnEndFlag && (millis() - Launch_completion_time > 7600))) {
        motor_flag = true;
        if (!First_Release_Signal) {
          Release_Signal_time = millis();
          First_Release_Signal = true;
        }

        Serial.println("解放します！！");
        Read_foto();
      }




      /*
           これを有効にした場合連続した、というのが蓄積されなくなる。これをIFで囲ってあげてると燃焼後また離床検出することが可能。
            overGcount = 0;
            decreaseCount = 0;
      */
    } else { //フライトピン終了カッコ
      Serial.println("フライトピン抜けていない");
    }

  }//20ミリ秒一回終了カッコ




  //__________________________SD書き込みコール__________________________________
  unsigned long ROCKET_TIME[3] = {Launch_completion_time, Release_Signal_time, Release_completion_time}; //離床時間をSDカードに保存するやつ。
  storeData(ROCKET_TIME, 3);

  while (SD_WRITE_NOW || writeRequest) {
    delay(1);
  }
  writeRequest = true;
  Make_Twelite_Log(Launch_completion_time);
  Make_Twelite_Log(Release_completion_time);


  /*
    ※※※※上のwhileについて。※※※※
    ・これは２コアで動いている。そのため、loop1の書き込み動作ではフラグの有無で書き込み処理が行われる。
    loopよりloop1のほうが処理が速かった場合すべてのデータを配列に入れた瞬間書き込まれるためうまく動作する。
    しかし、loop1よりloopの方が速かった場合書き込みする前に配列にどんどんデータが入っていくためずれていく。
    それをなくすため、書き込み中は配列に数値を代入しないようにフラグを立てている。
  */




  //___________トワイライトに送信________________________________________
  Sent_TWELITE();

}






unsigned long lastWriteMicros = 0;
const unsigned long sdWriteInterval = 50000; // 50000

void loop1() {
  unsigned long currentMicros = micros();

  if (currentMicros - lastWriteMicros >= sdWriteInterval) {
    lastWriteMicros = currentMicros;

    if (error_SD) {  // ✅ 修正済み：SDカードが正常なときのみ書き込み
      SD_WRITE_NOW = true;

      if (writeRequest) {
        File dataFile = SD.open("datalog.txt", FILE_WRITE);
        if (dataFile) {
          dataFile.print(millis());
          dataFile.print(",");
          delayMicroseconds(1);
          for (int i = 0; i < writeIndex; i++) {
            dataFile.print(writeData[i]);
            dataFile.print(",");
            delayMicroseconds(1);
          }
          dataFile.println();
          delayMicroseconds(5);
          dataFile.flush();
          dataFile.close();
          delay(5);
        }

        if (debug) Serial.println("SD書き込み完了");

        writeIndex = 0;
        writeRequest = false;
      }

      SD_WRITE_NOW = false;
    } else {
      if (debug) Serial.println("NO SD______________________________________________");
    }
  }
}
