yumeno-robot/ROCKET-Spica/A班電装プログラム/rocket/flite_pin.ino

void Read_filtepin() {

  int situation_flitepin = analogRead(28);
  //Serial.println(situation_flitepin);
  if (situation_flitepin < 80 || Write_Sd_FirstTIME == true) {//開いていないもしくは一回書いてる。
    return;
  } else if (situation_flitepin > 80 && Write_Sd_FirstTIME == false) {//初めて開いた。
    Flight = true;
    Write_Sd_FirstTIME = true;
    //Serial.println("フライトピン　切れた。");
    
  }

}


/*
  int Return_Filght_time() {
  return flight_time;
  }
*/
