yumeno-robot/ROCKET-Spica/(commit log)

2025-10-14 一回プログラム保存
    [Rocket_First-examination.kicad_pcb, Rocket_First-examination.kicad_sch]
2025-10-15 SDカードのプログラムを修正しました。これからトワイライトとGPSのプログラムを追加していきます
2025-10-15 トワイライト受信プログラム記述、テスト送信プログラム記述
2025-10-15 トワイライト関数完成
2025-10-15 SDカード完成！！！
2025-10-18 解放指令が完璧になりました！！あとは全体アルゴリズムで完成だと思います
2025-10-20 一回保存
2025-10-20 搭載計器実物がないため、実験できていない。がむしゃらに書いてみたわ
2025-10-22 多分アルゴリズム系いい感じ。あとはSerialで確認できるようにする
2025-10-22 燃焼中 燃焼終了 離床 フライトピン 検出完成
2025-10-22 一回完成
2025-10-23 ほぼほぼ完成です。審査書歯あと気圧を利用した解放動作だけ。あとはSDカードの動作を完璧にすれば完成なのでは？
2025-10-27 SDカードめっちゃ綺麗に入れれるようになった！！！あとはデータまとめよ！あと気圧のアルゴリズム消そう！
2025-10-27 改行できていないエラー修復成功。あとはもう一度保存したいデータまとめてみー
2025-10-27 あとはテレメトリーをやれば完成！！あttあと離床検知の気圧も直すわ
2025-10-28 一応完成。何かあったらここから
2025-10-28 あと気圧アルゴリズムの消去
2025-10-29 アルゴリズム気圧を消去したら終わり！！！！！あと受信のコード直しといてー
2025-10-29 ほぼ完成何があってもここから
2025-10-29 完成！！パラメーター変えといてーあともう一回通信試験やっといてー
2025-11-15 完成です。これでロケット打ちます
2025-12-05 ファイルの整理が終わったぜ
    [MCU_circuits.kicad_pcb, MCU_circuits.kicad_sch, Rocket_CDR_1.kicad_pcb, Rocket_CDR_1.kicad_sch, Rocket_First-examination.kicad_pcb, Rocket_First-examination.kicad_sch, ログデータエクセル.xlsx]
2026-01-18 審査書追加
